vedderb/QuadcopterSystem/Documentation/Figures/HW_Diagram_Quadcopter.pdf

## Ranging Board

## Mainboard

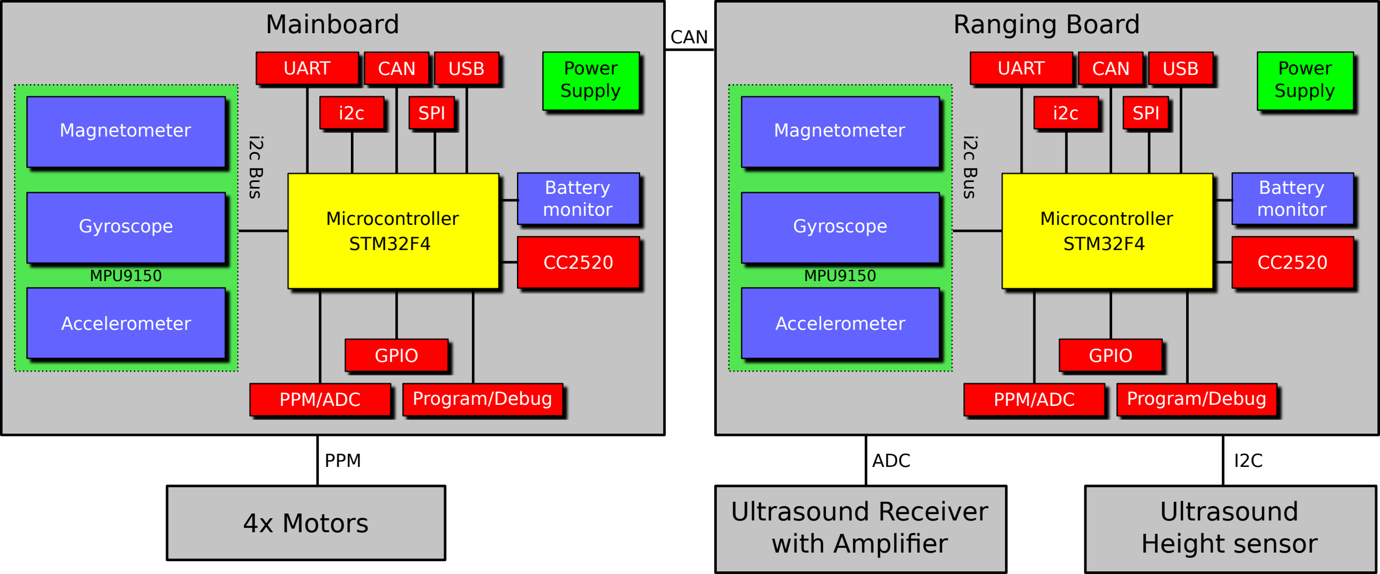
[picture p15: page 1]

Magnetometer

Gyroscope

Accelerometer

UART

i2c Bus

CAN | USB
PPM/ADC | Program/Debug

Power
Supply

CC2520

Microcontroller
STM32F4

i2c

GPIO

Battery
monitor

MPU9150

SPI

4x Motors | Ultrasound Height sensor

ADC

CAN

Magnetometer

Gyroscope

Accelerometer

UART

i2c Bus

CAN USB

Program/Debug PPM/ADC

Power
Supply

CC2520

Microcontroller
STM32F4

i2c

GPIO

Battery
monitor

MPU9150

SPI

## Ultrasound Receiver with Amplifier

PPM | I2C

PPM/ADC
