vedderb/QuadcopterSystem/Documentation/Figures/anchor.jpg

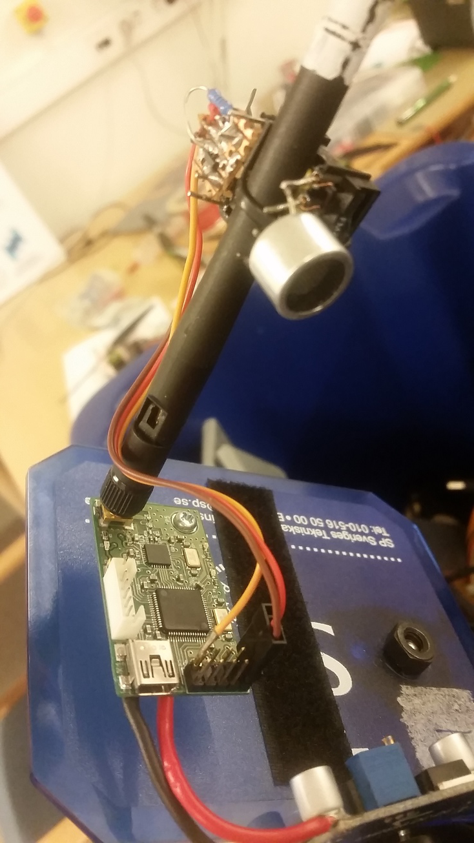
Documentation/Figures/anchor.jpg
