vedderb/QuadcopterSystem/Documentation/Figures/quad_pcb.jpg

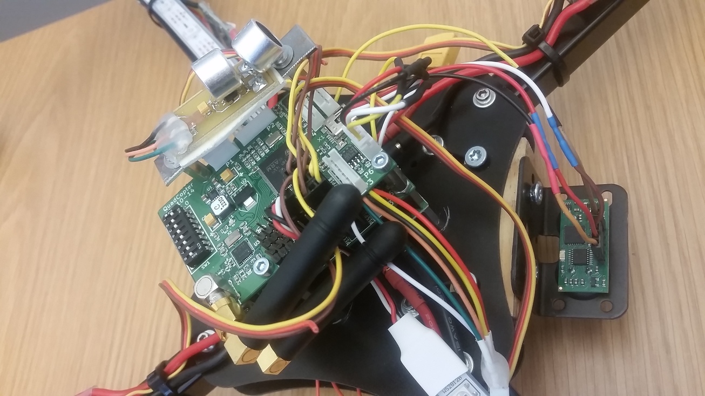
Documentation/Figures/quad_pcb.jpg
