vedderb/QuadcopterSystem/Documentation/Figures/quadcoptertool_3.png

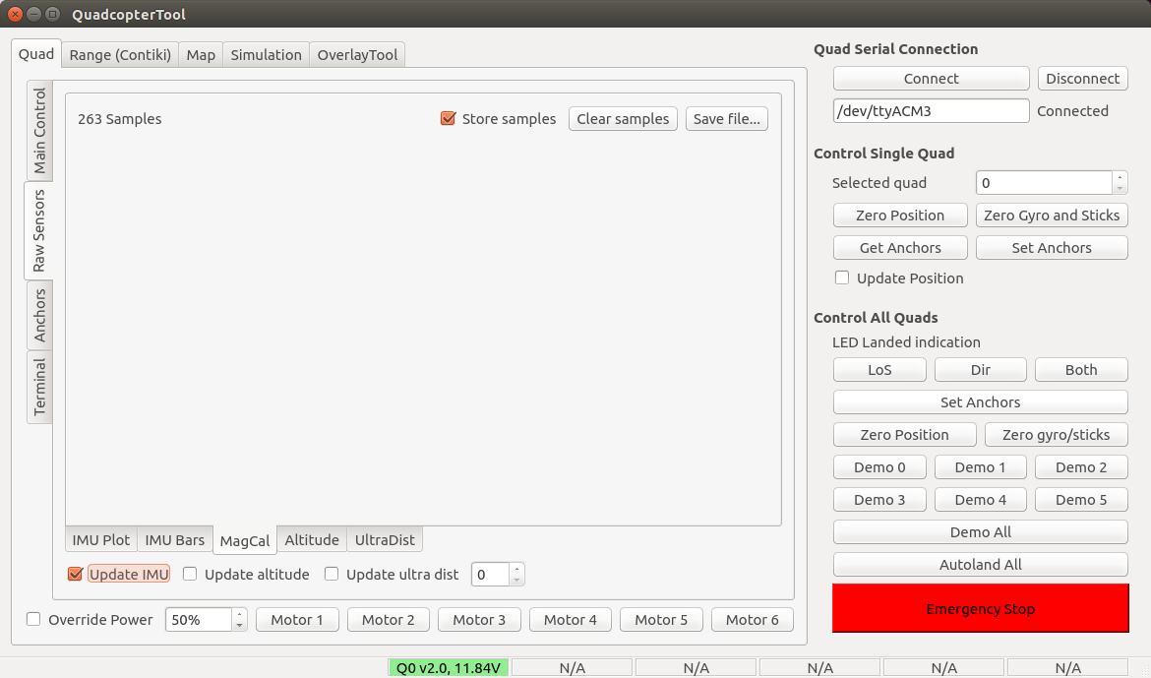
Documentation/Figures/quadcoptertool_3.png
