vedderb/QuadcopterSystem/Documentation/Figures/quadcoptertool_4.png

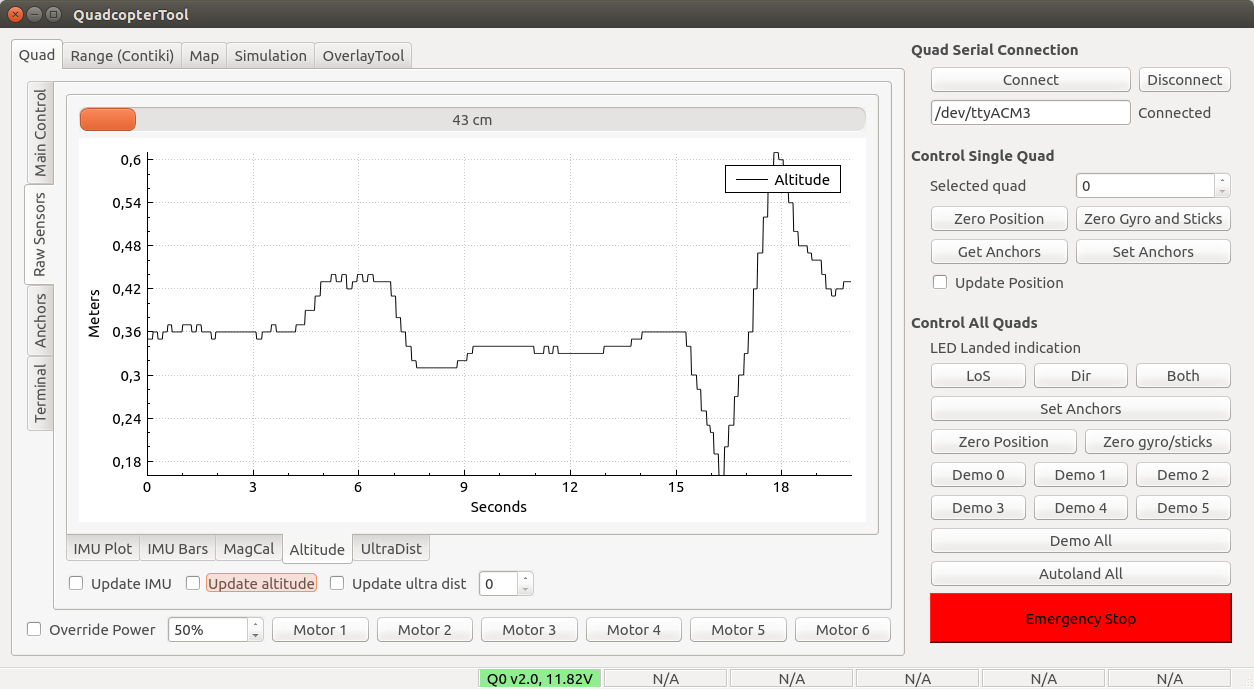
Documentation/Figures/quadcoptertool_4.png
