vedderb/QuadcopterSystem/Documentation/Figures_pdf_png/QuadcopterMain.png

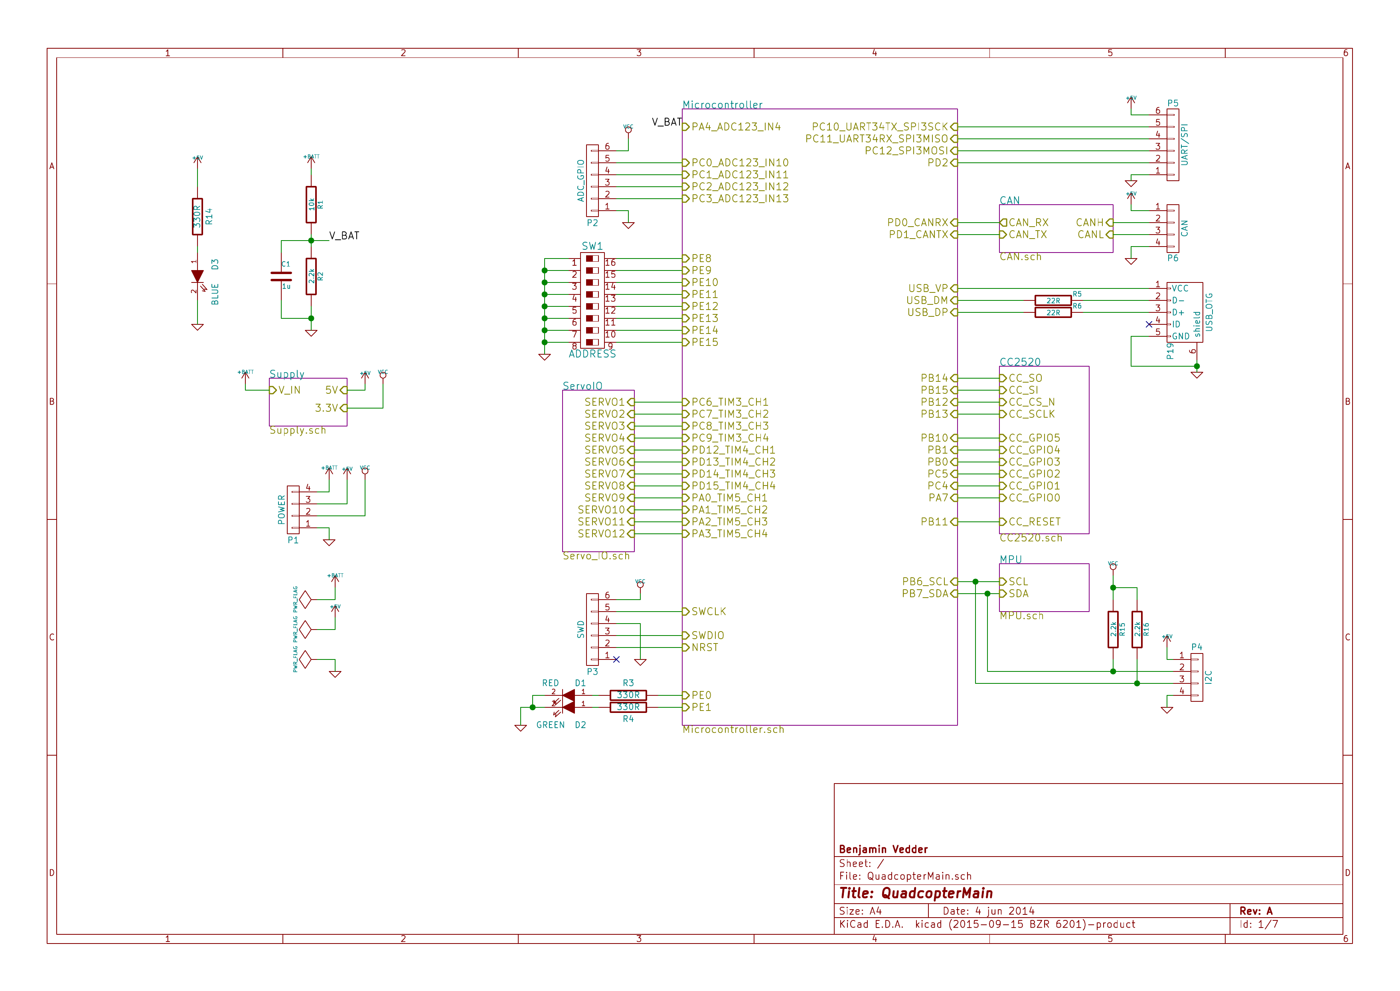
Documentation/Figures_pdf_png/QuadcopterMain.png
