vedderb/QuadcopterSystem/Hardware/MainBoard/Pictures/QuadcopterMain.png

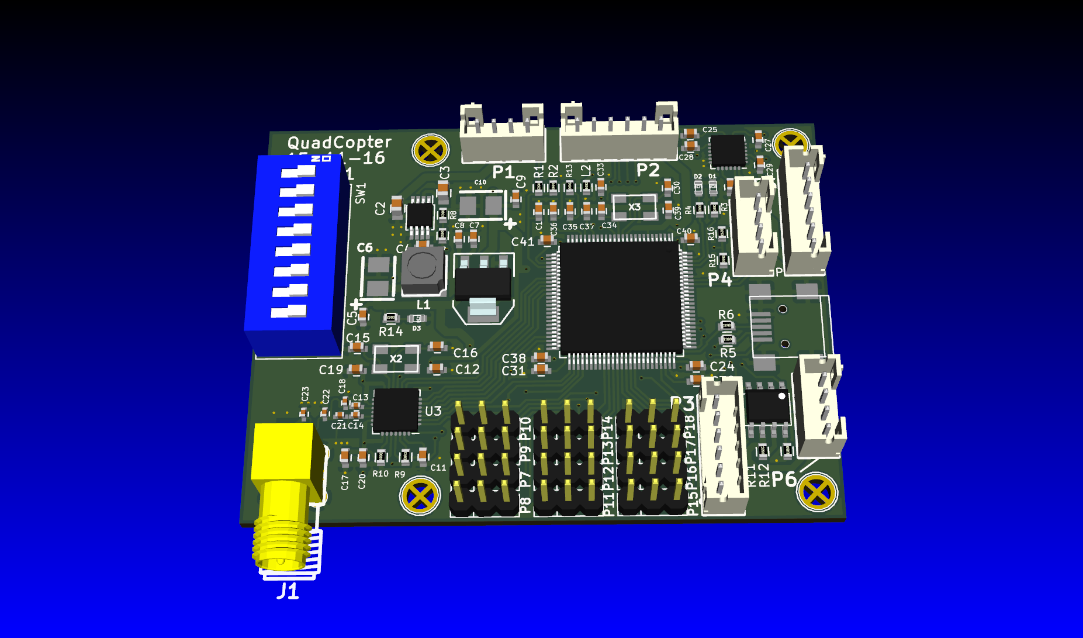
Hardware/MainBoard/Pictures/QuadcopterMain.png
