vedderb/QuadcopterSystem/(list of files, cad)

Other CAD files:
Linux/QuadcopterTool/Models/quadrotor_base.blend
