vedderb/QuadcopterSystem/Documentation/Figures/CopterSimSetupGUI.pdf

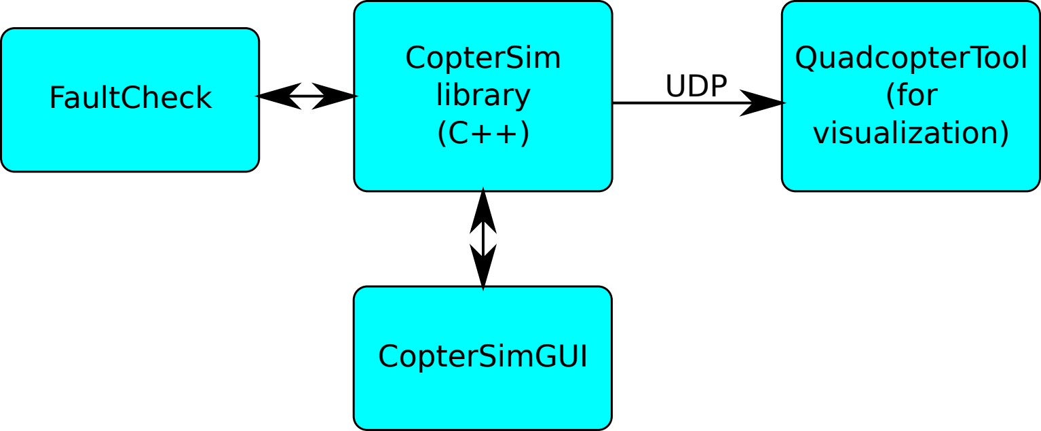
[picture p32: figure]
CopterSim library (C++); QuadcopterTool (for visualization); CopterSimGUI; UDP FaultCheck
