vedderb/QuadcopterSystem/Hardware/MainBoard/QuadcopterMain.pdf

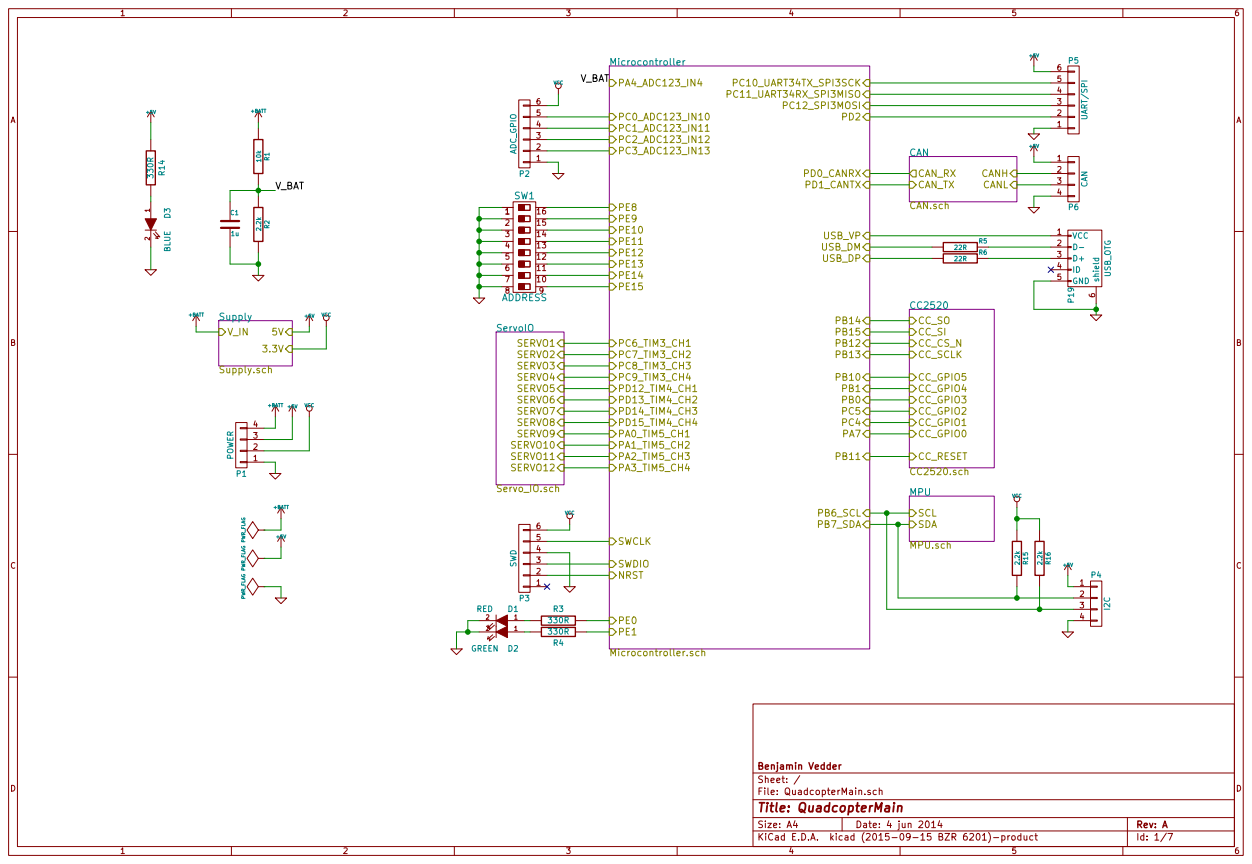
[picture p33: page 1]

File: QuadcopterMain.sch Sheet: / Benjamin Vedder

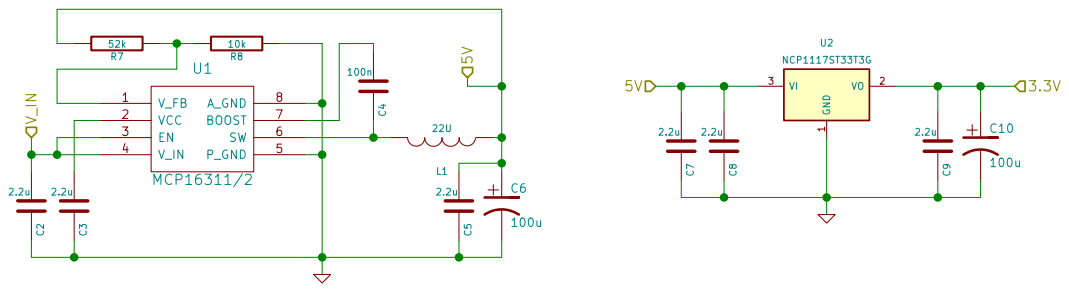
[picture p34: page 2]

Benjamin Vedder
Sheet: /Supply/
File: Supply.sch
Id: 2/7 Title: Voltage regulators

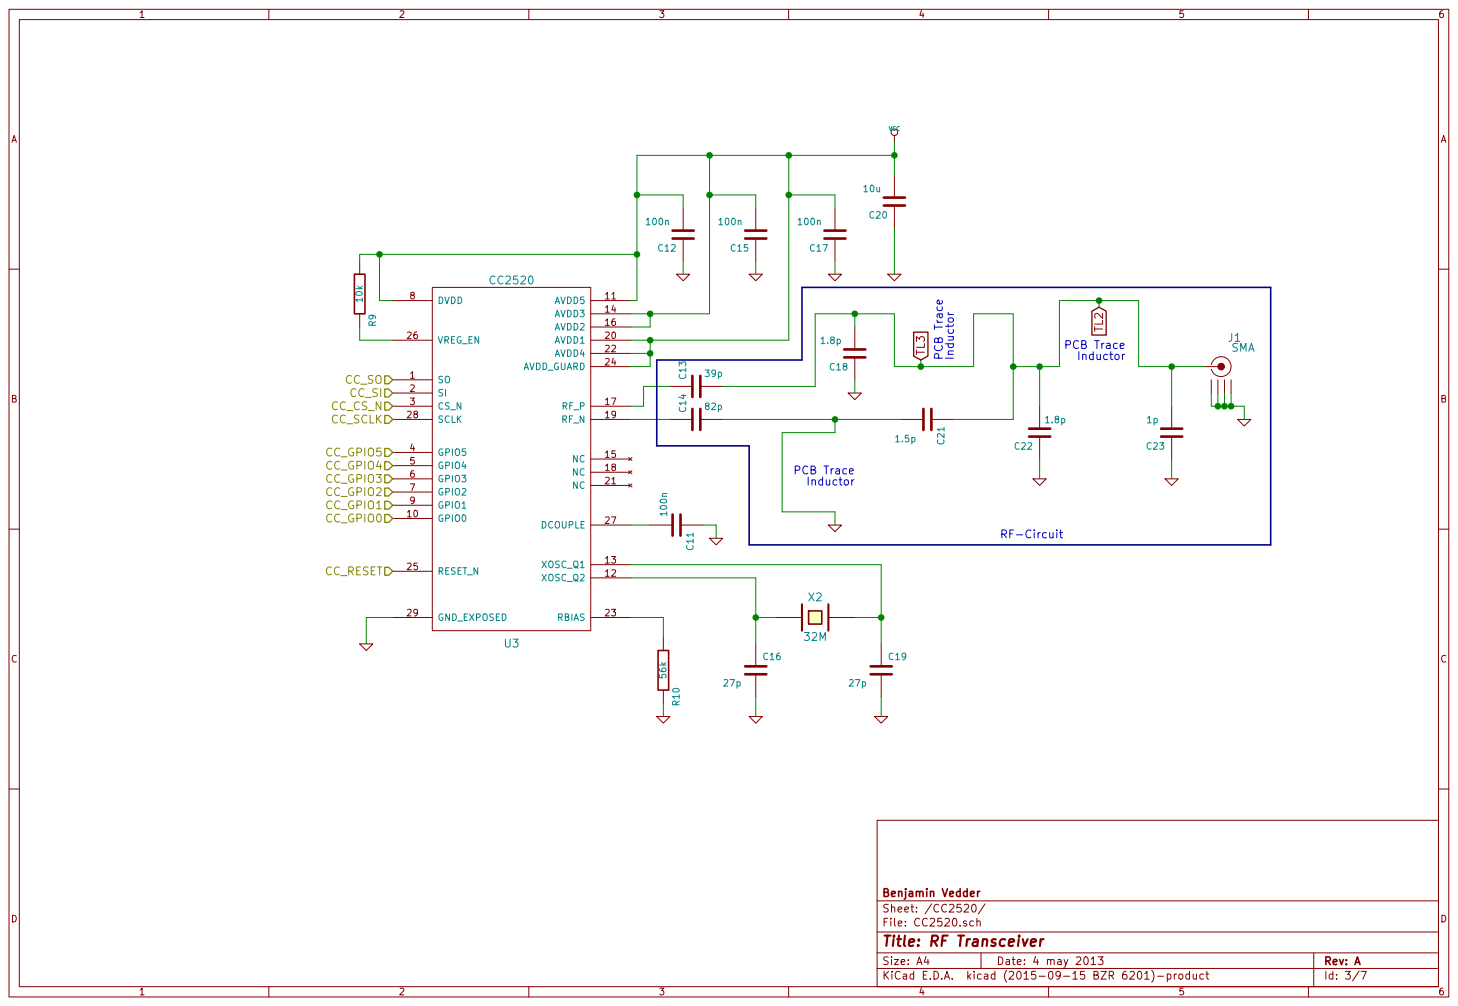
[picture p35: page 3]

Id: 3/7 Title: RF Transceiver File: CC2520.sch Sheet: /CC2520/ Benjamin Vedder

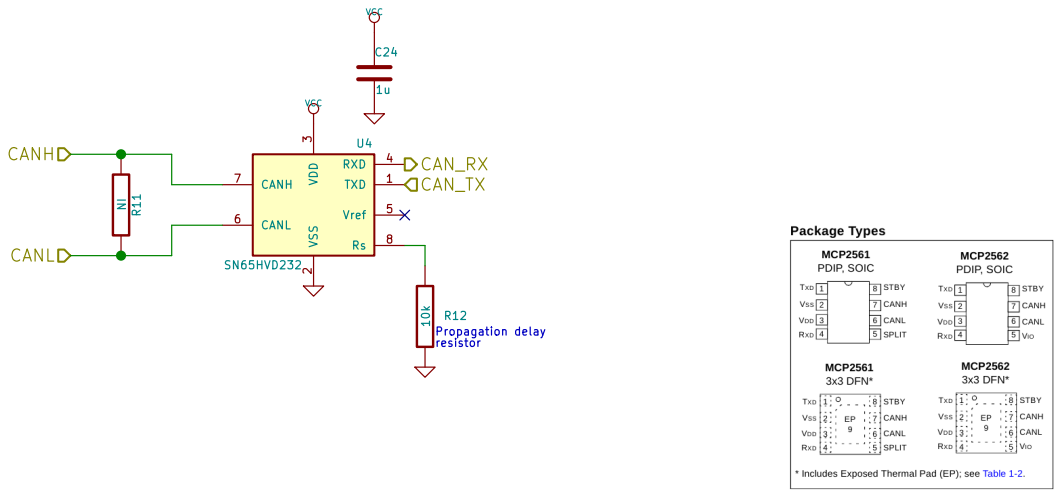
[picture p36: page 4]

3 RXD 4 Vref 5 CANL 6 CANH 7 Rs 8 U4 SN65HVD232

Id: 4/7 Title: CAN BUS transceiver File: CAN.sch Sheet: /CAN/ Benjamin Vedder

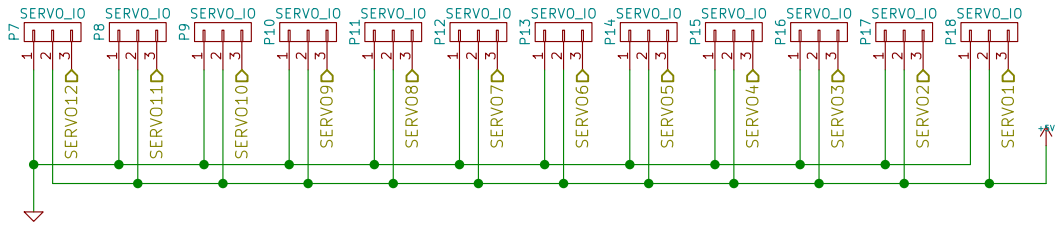
[picture p37: page 5]

File: Servo_IO.sch Sheet: /ServoIO/ Benjamin Vedder

Id: 5/7 Title: PPM IO

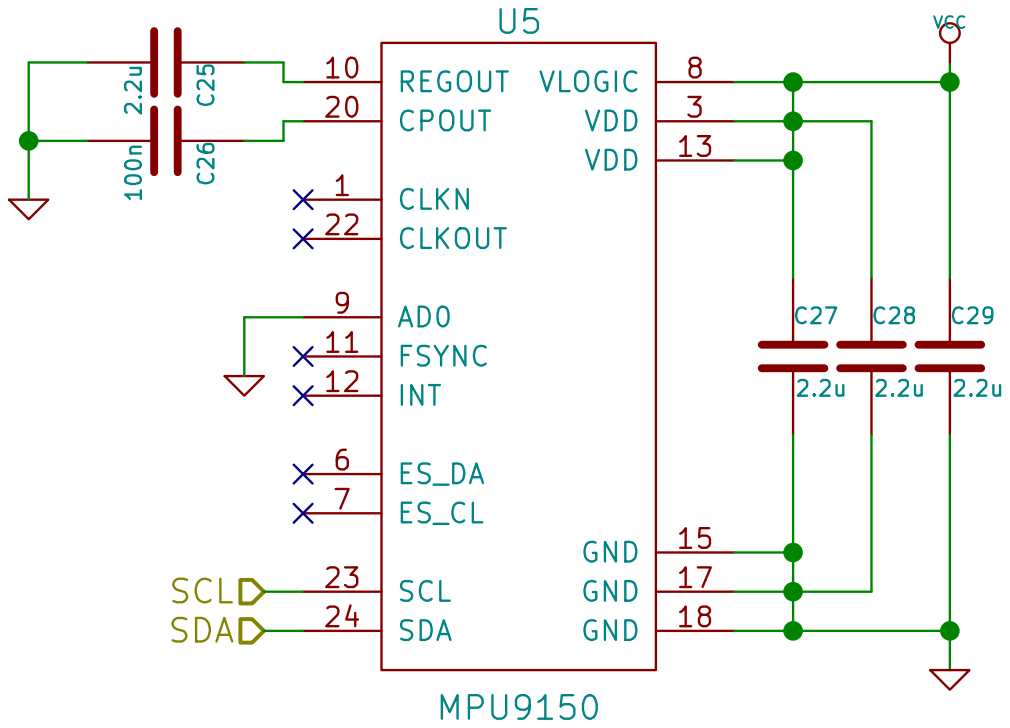
[picture p38: page 6]

File: MPU.sch Sheet: /MPU/ Benjamin Vedder

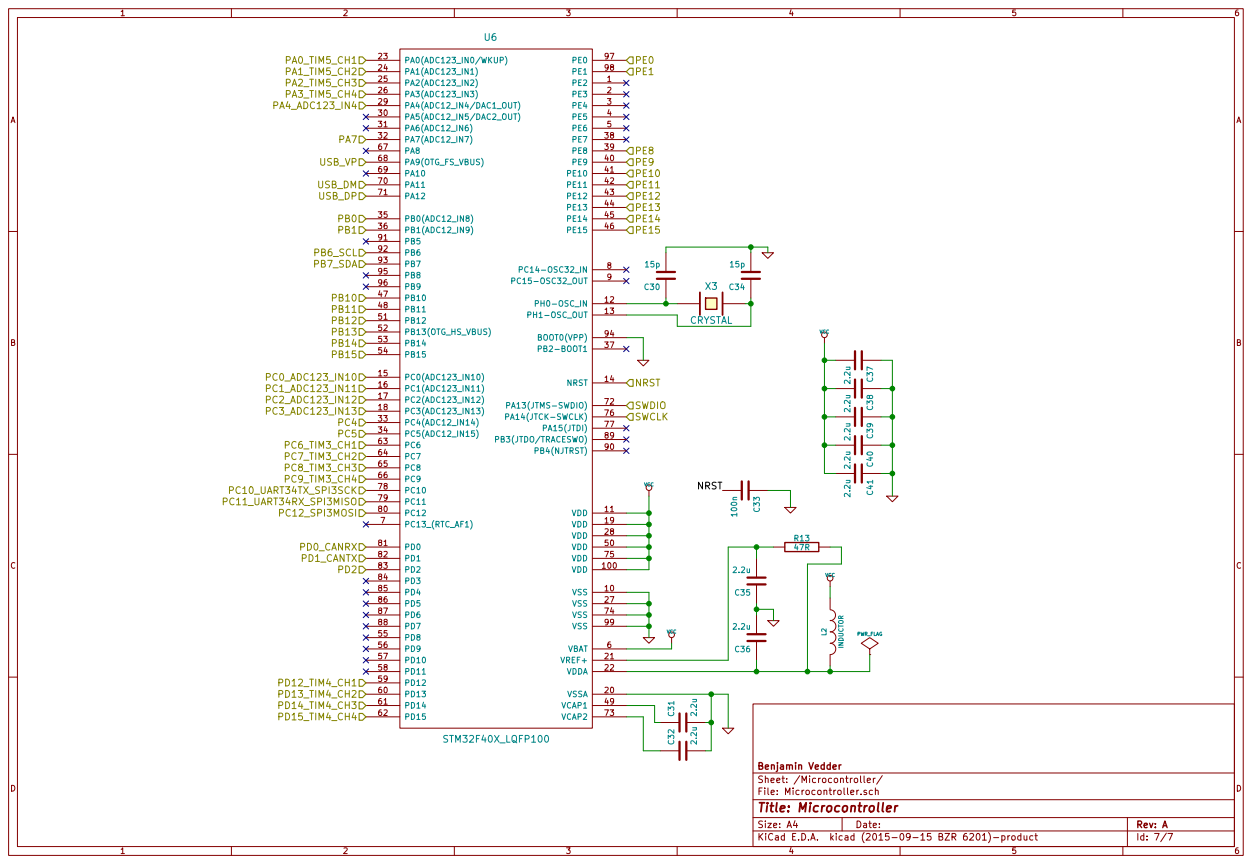
[picture p39: page 7]
