vedderb/QuadcopterSystem/Documentation/Figures/QuadHwSystem.pdf

# Linux Computer

# Clock Synchronization

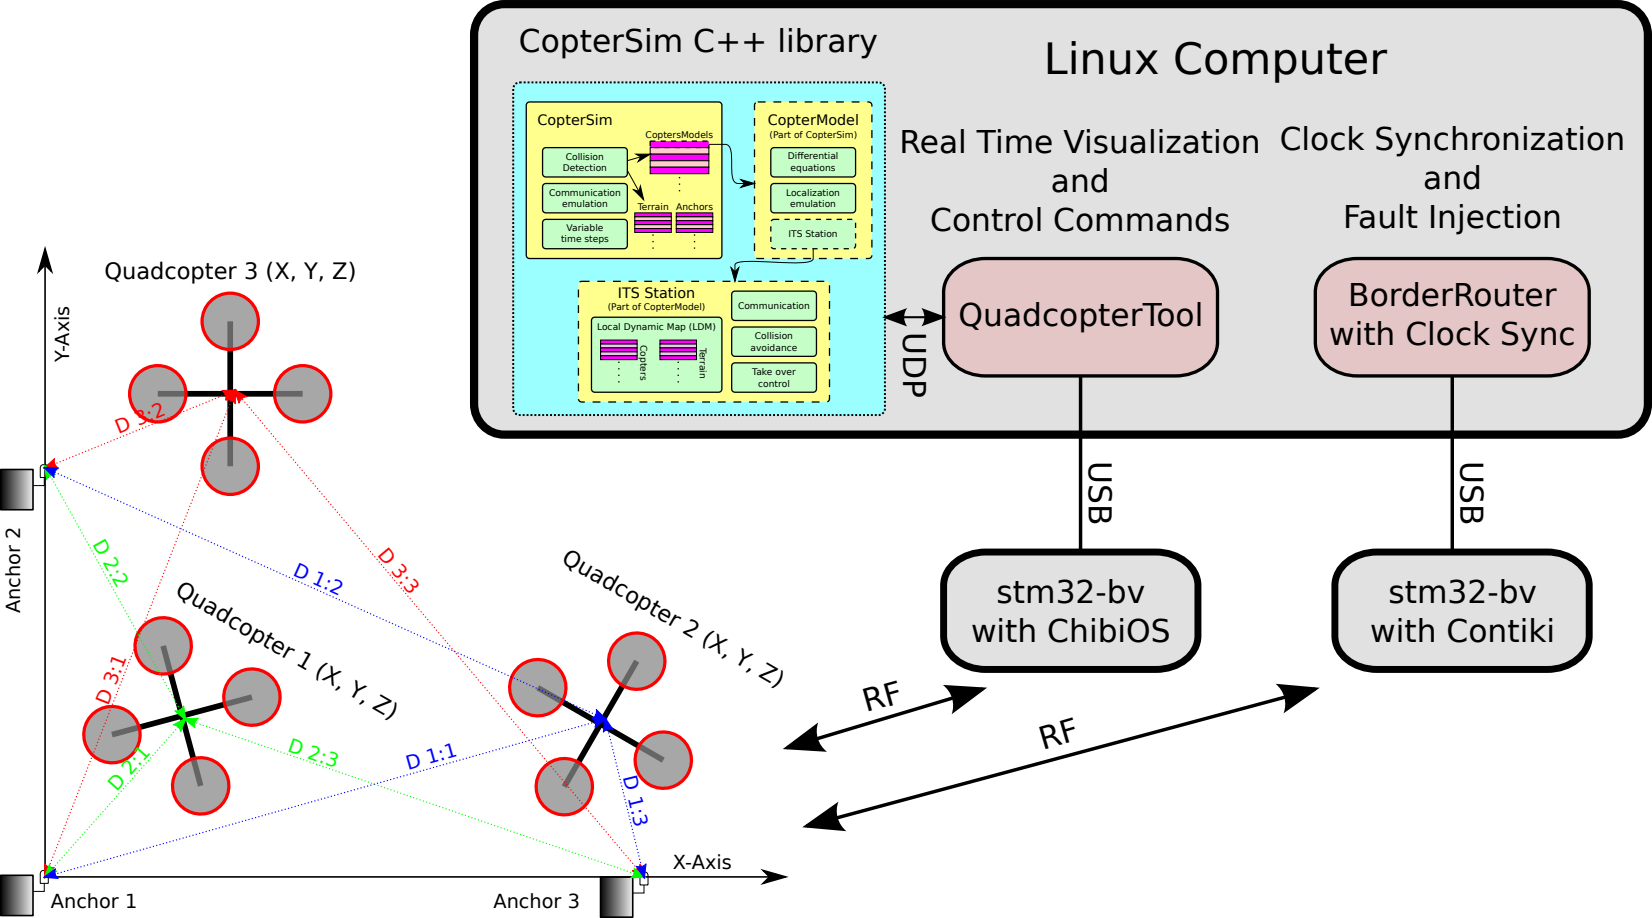
[picture p40: page 1]
X-Axis; Y-Axis; Anchor 1; Anchor 2; Anchor 3; Quadcopter 1 (X, Y, Z); Quadcopter 2 (X, Y, Z); Quadcopter 3 (X, Y, Z); QuadcopterTool; BorderRouter; stm32-bv with ChibiOS; stm32-bv with Contiki; USB; and Fault Injection; and Control Commands; CopterSim; Collision Detection; Communication emulation; Variable time steps; CoptersModels; Differential equations; ITS Station; CopterSim C++ library; Local Dynamic Map (LDM) Copters; Terrain; Communication; Collision avoidance; Take over control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

CopterModel
(Part of CopterSim)

Real Time Visualization

ITS Station
(Part of CopterModel)

with Clock Sync
