vedderb/QuadcopterSystem/Documentation/Figures/CopterSim.pdf

## CopterSim

## CopterModel

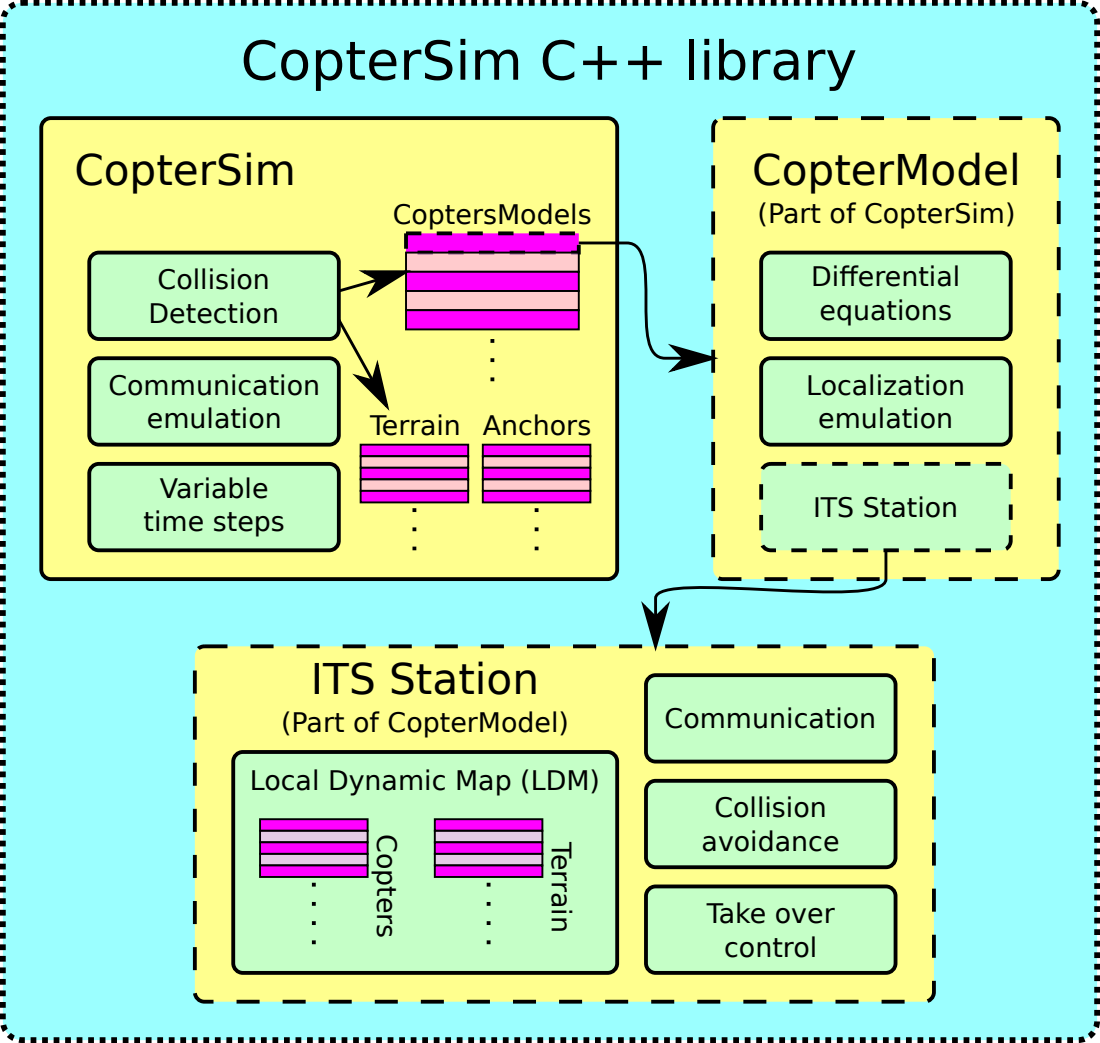
[picture p41: page 1]
Collision Detection; Communication emulation; Variable time steps; CoptersModels; Differential equations; ITS Station; CopterSim C++ library; Local Dynamic Map (LDM) Copters; Terrain; Communication; Collision avoidance; Take over control; Localization; Anchors; emulation

(Part of CopterSim)

ITS Station
(Part of CopterModel)
