vedderb/QuadcopterSystem/Hardware/MainBoard/QuadcopterMain.kicad_pcb

## KiCad design Hardware/MainBoard/QuadcopterMain.kicad_pcb (2015-12-16)

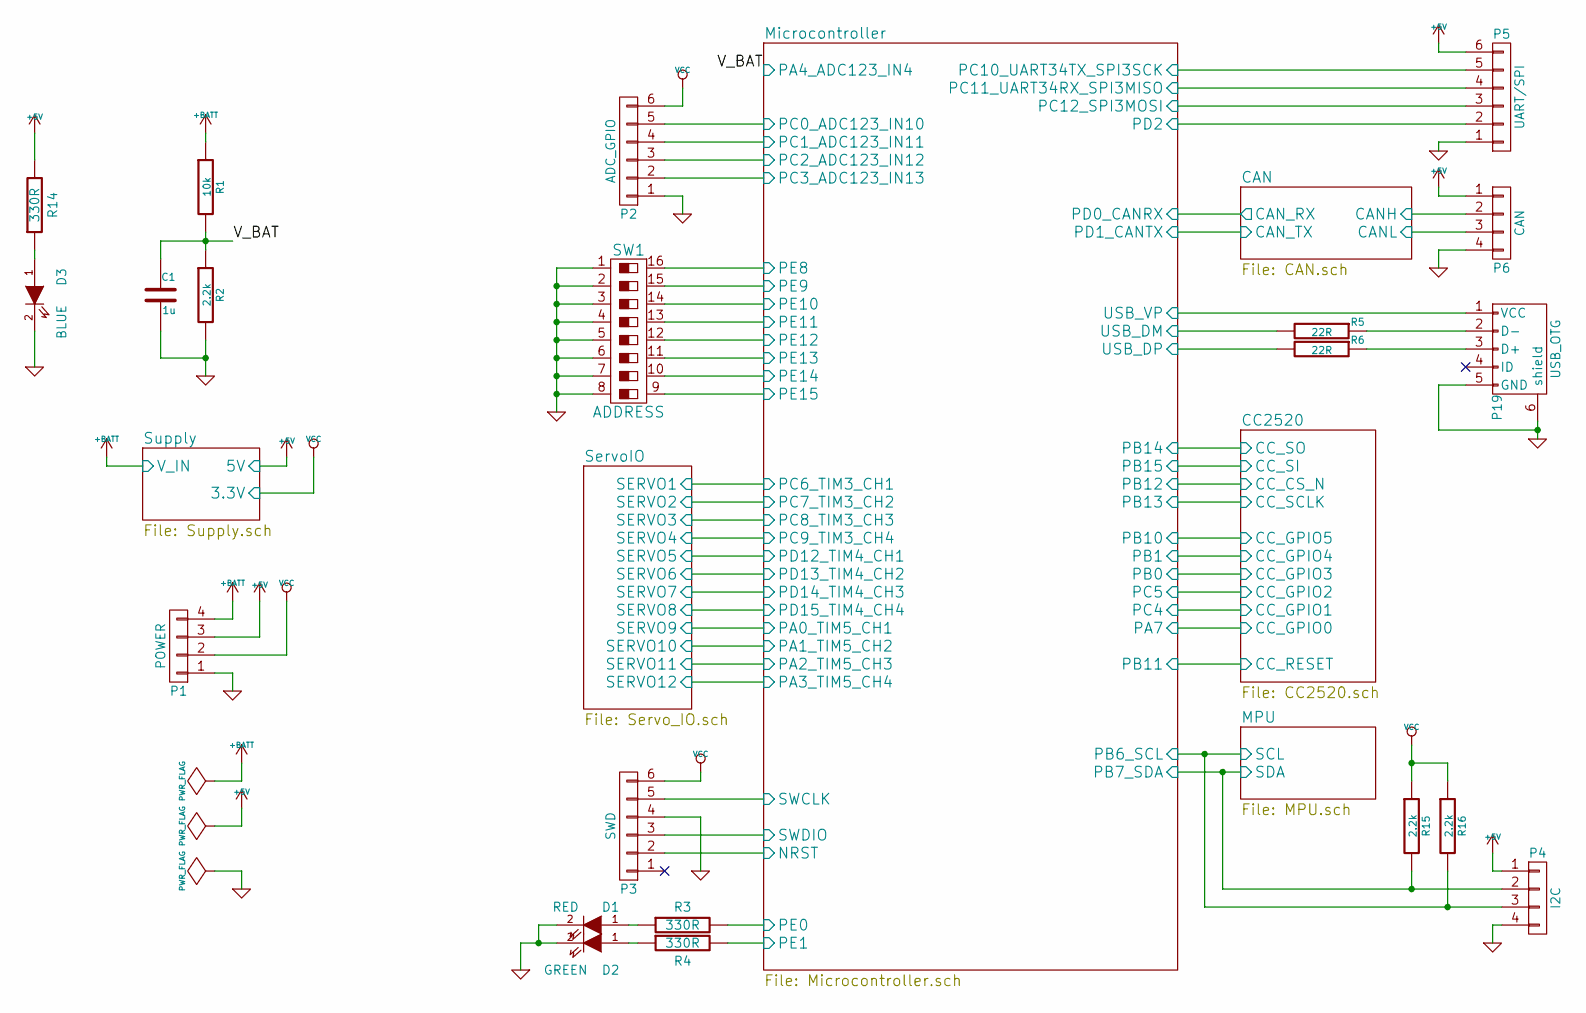
[picture p42: schematic QuadcopterMain.sch]

Parts:
C1: 1u; C_0603
D1: RED; LED-0603
D2: GREEN; LED-0603
D3: BLUE; LED-0603
P1: POWER; b4b-ph-kl
P2: ADC_GPIO; b6b-ph-kl
P3: SWD; b6b-ph-kl
P4: I2C; b4b-ph-kl
P5: UART/SPI; b6b-ph-kl
P6: CAN; b4b-ph-kl
P19: USB_OTG; USB_Mini-B
R1: 10k; R_0603
R2, R15, R16: 2.2k; R_0603
R3, R4, R14: 330R; R_0603
R5, R6: 22R; R_0603
SW1: ADDRESS; SW_DIP_x8_Slide

Connections:
+5V: P1.3, P4.1, P5.6, P6.1, R14.2; also elsewhere on the board
+BATT: P1.4, R1.1; also elsewhere on the board
/CAN/CANH: P6.2; also elsewhere on the board
/CAN/CANL: P6.3; also elsewhere on the board
/Microcontroller/NRST: P3.2; also elsewhere on the board
/Microcontroller/PA4_ADC123_IN4: C1.1, R1.2, R2.1; also elsewhere on the board
/Microcontroller/PB6_SCL: P4.3, R16.2; also elsewhere on the board
/Microcontroller/PB7_SDA: P4.2, R15.2; also elsewhere on the board
/Microcontroller/PC0_ADC123_IN10: P2.5; also elsewhere on the board
/Microcontroller/PC1_ADC123_IN11: P2.4; also elsewhere on the board
/Microcontroller/PC2_ADC123_IN12: P2.3; also elsewhere on the board
/Microcontroller/PC3_ADC123_IN13: P2.2; also elsewhere on the board
/Microcontroller/PC10_UART34TX_SPI3SCK: P5.5; also elsewhere on the board
/Microcontroller/PC11_UART34RX_SPI3MISO: P5.4; also elsewhere on the board
/Microcontroller/PC12_SPI3MOSI: P5.3; also elsewhere on the board
/Microcontroller/PD2: P5.2; also elsewhere on the board
/Microcontroller/PE0: R3.2; also elsewhere on the board
/Microcontroller/PE1: R4.2; also elsewhere on the board
/Microcontroller/PE8: SW1.16; also elsewhere on the board
/Microcontroller/PE9: SW1.15; also elsewhere on the board
/Microcontroller/PE10: SW1.14; also elsewhere on the board
/Microcontroller/PE11: SW1.13; also elsewhere on the board
/Microcontroller/PE12: SW1.12; also elsewhere on the board
/Microcontroller/PE13: SW1.11; also elsewhere on the board
/Microcontroller/PE14: SW1.10; also elsewhere on the board
/Microcontroller/PE15: SW1.9; also elsewhere on the board
/Microcontroller/SWCLK: P3.5; also elsewhere on the board
/Microcontroller/SWDIO: P3.3; also elsewhere on the board
/Microcontroller/USB_DM: R5.2; also elsewhere on the board
/Microcontroller/USB_DP: R6.2; also elsewhere on the board
/Microcontroller/USB_VP: P19.1 (VCC); also elsewhere on the board
GND: C1.2, D1.2 (K), D2.2 (K), D3.2 (K), P1.1, P2.1, P3.4, P4.4, P5.1, P6.4, P19.5 (GND), P19.6 (shield), R2.2, SW1.1, SW1.2, SW1.3, SW1.4, SW1.5, SW1.6, SW1.7, SW1.8; also elsewhere on the board
unnamed: D1.1 (A), R3.1
unnamed: D2.1 (A), R4.1
unnamed: D3.1 (A), R14.1
unnamed: P19.2 (D-), R5.1
unnamed: P19.3 (D+), R6.1
VCC: P1.2, P2.6, P3.6, R15.1, R16.1; also elsewhere on the board

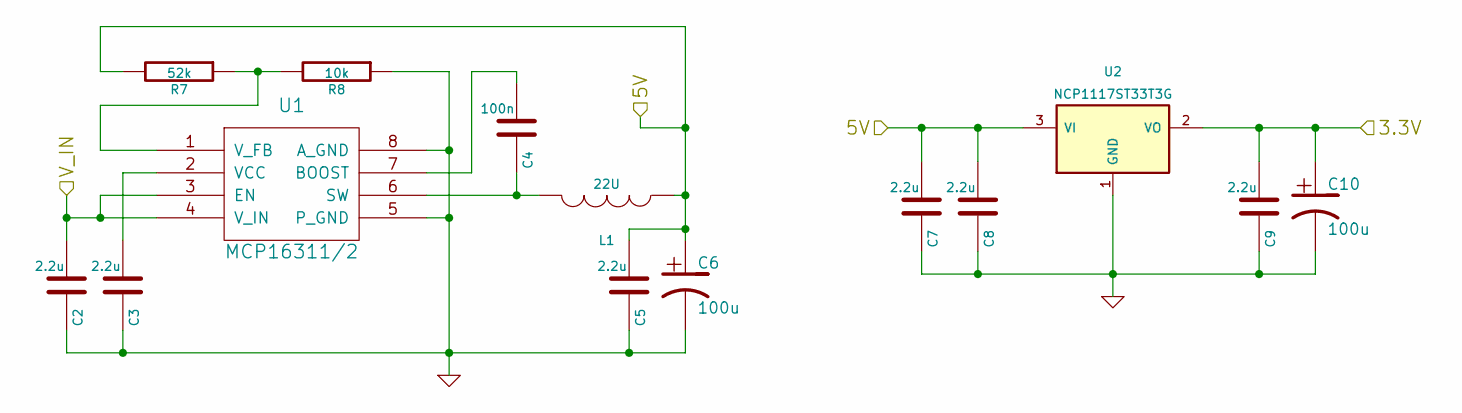
[picture p43: schematic Supply.sch, Voltage regulators]

Parts:
C2, C3: 2.2u; C_0805
C4: 100n; C_0603
C5, C7, C8, C9: 2.2u; C_0603
C6, C10: 100u; TantalC_SizeB_EIA-3528_Reflow
L1: 22U; inductor_smd_4.8x2.8mm
R7: 52k; R_0603
R8: 10k; R_0603
U1: MCP16311/2; MSOP-8_3x3mm_Pitch0.65mm
U2: NCP1117ST33T3G; SOT-223

Connections:
+5V: C5.2, C6.1, C7.2, C8.2, L1.1, R7.2, U2.3 (VI); also elsewhere on the board
+BATT: C2.2, U1.3 (EN), U1.4 (V_IN); also elsewhere on the board
GND: C2.1, C3.1, C5.1, C6.2, C7.1, C8.1, C9.1, C10.2, R8.1, U1.5 (P_GND), U1.8 (A_GND), U2.1 (GND); also elsewhere on the board
unnamed: C3.2, U1.2 (VCC)
unnamed: C4.1, L1.2, U1.6 (SW)
unnamed: C4.2, U1.7 (BOOST)
unnamed: R7.1, R8.2, U1.1 (V_FB)
VCC: C9.2, C10.1, U2.2 (VO); also elsewhere on the board

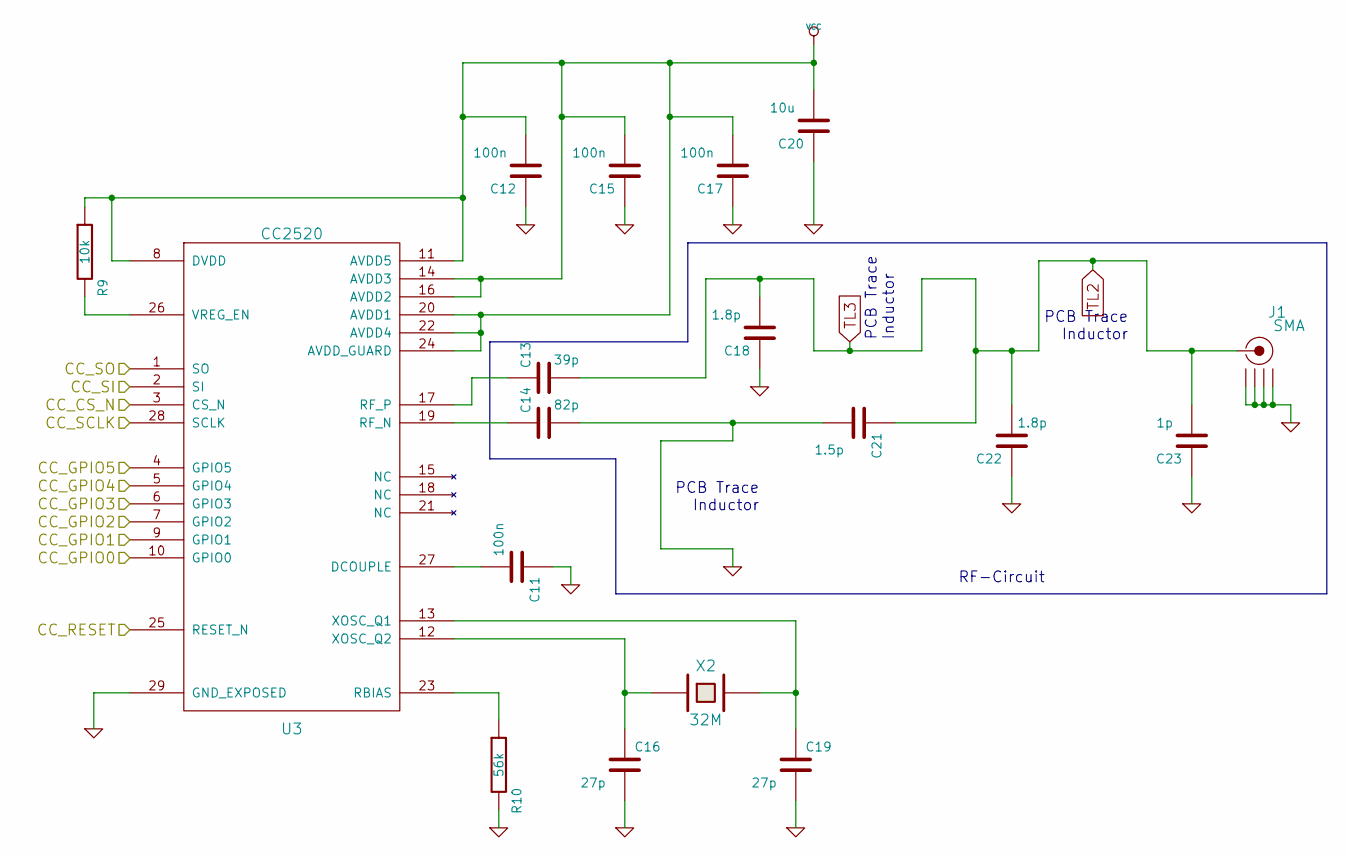
[picture p44: schematic CC2520.sch, RF Transceiver]

Parts:
C11, C12, C15, C17: 100n; C_0603
C13: 39p; C_0402
C14: 82p; C_0402
C16, C19: 27p; C_0603
C18, C22: 1.8p; C_0402
C20: 10u; C_0603
C21: 1.5p; C_0402
C23: 1p; C_0402
J1: SMA; sma_90_r300.124.403
R9: 10k; R_0603
R10: 56k; R_0603
U3: CC2520; QFN-28-1EP_5x5mm_Pitch0.5mm
X2: 32M; Crystal_5x3mm

Connections:
/CC2520/CC_CS_N: U3.3 (CS_N); also elsewhere on the board
/CC2520/CC_GPIO0: U3.10 (GPIO0); also elsewhere on the board
/CC2520/CC_GPIO1: U3.9 (GPIO1); also elsewhere on the board
/CC2520/CC_GPIO2: U3.7 (GPIO2); also elsewhere on the board
/CC2520/CC_GPIO3: U3.6 (GPIO3); also elsewhere on the board
/CC2520/CC_GPIO4: U3.5 (GPIO4); also elsewhere on the board
/CC2520/CC_GPIO5: U3.4 (GPIO5); also elsewhere on the board
/CC2520/CC_RESET: U3.25 (RESET_N); also elsewhere on the board
/CC2520/CC_SCLK: U3.28 (SCLK); also elsewhere on the board
/CC2520/CC_SI: U3.2 (SI); also elsewhere on the board
/CC2520/CC_SO: U3.1 (SO); also elsewhere on the board
GND: C11.1, C12.1, C14.2, C15.1, C16.2, C17.1, C18.1, C19.2, C20.1, C21.2, C22.1, C23.1, J1.2 (GND1), J1.3 (GND2), J1.4 (GND3), J1.5 (GND4), R10.2, U3.29 (GND_EXPOSED); also elsewhere on the board
unnamed: C11.2, U3.27 (DCOUPLE)
unnamed: C13.1, U3.17 (RF_P)
unnamed: C14.1, U3.19 (RF_N)
unnamed: C16.1, U3.12 (XOSC_Q2), X2.1
unnamed: C19.1, U3.13 (XOSC_Q1), X2.2
unnamed: R9.2, U3.26 (VREG_EN)
unnamed: R10.1, U3.23 (RBIAS)
TL2: C13.2, C18.2, C21.1, C22.2, C23.2, J1.1 (RF)
VCC: C12.2, C15.2, C17.2, C20.2, R9.1, U3.8 (DVDD), U3.11 (AVDD5), U3.14 (AVDD3), U3.16 (AVDD2), U3.20 (AVDD1), U3.22 (AVDD4), U3.24 (AVDD_GUARD); also elsewhere on the board

Notes on the sheet:
RF-Circuit
PCB Trace Inductor

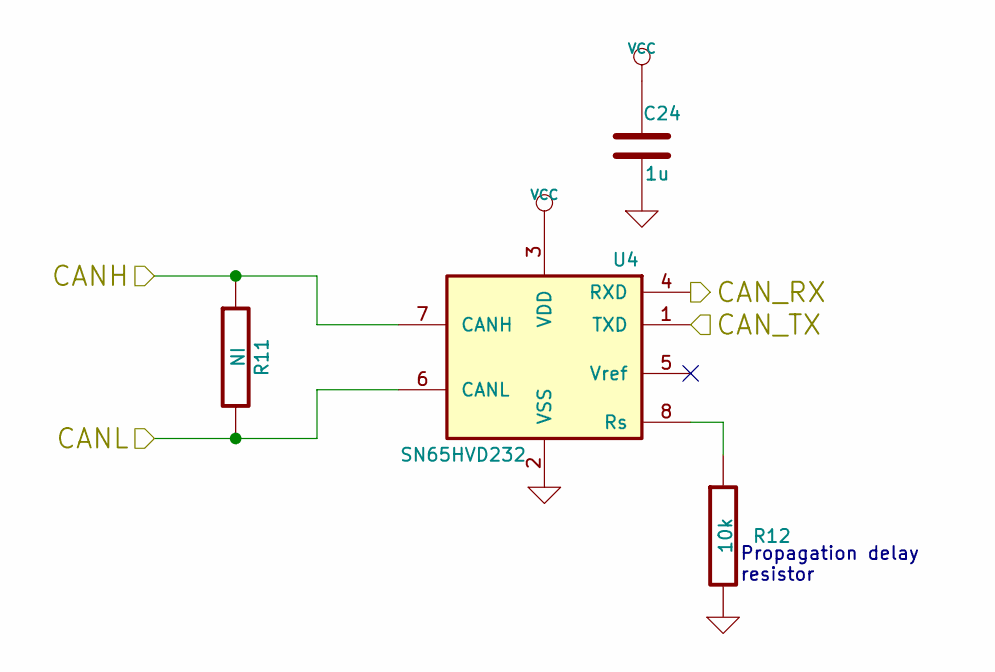
[picture p45: schematic CAN.sch, CAN BUS transceiver]

Parts:
C24: 1u; C_0603
R11: NI; R_0603
R12: 10k; R_0603
U4: SN65HVD232; SOIC-8-W

Connections:
/CAN/CANH: R11.1, U4.7 (CANH); also elsewhere on the board
/CAN/CANL: R11.2, U4.6 (CANL); also elsewhere on the board
/CAN/CAN_RX: U4.4 (RXD); also elsewhere on the board
/CAN/CAN_TX: U4.1 (TXD); also elsewhere on the board
GND: C24.2, R12.2, U4.2 (VSS); also elsewhere on the board
unnamed: R12.1, U4.8 (Rs)
VCC: C24.1, U4.3 (VDD); also elsewhere on the board

Notes on the sheet:
Propagation delay resistor

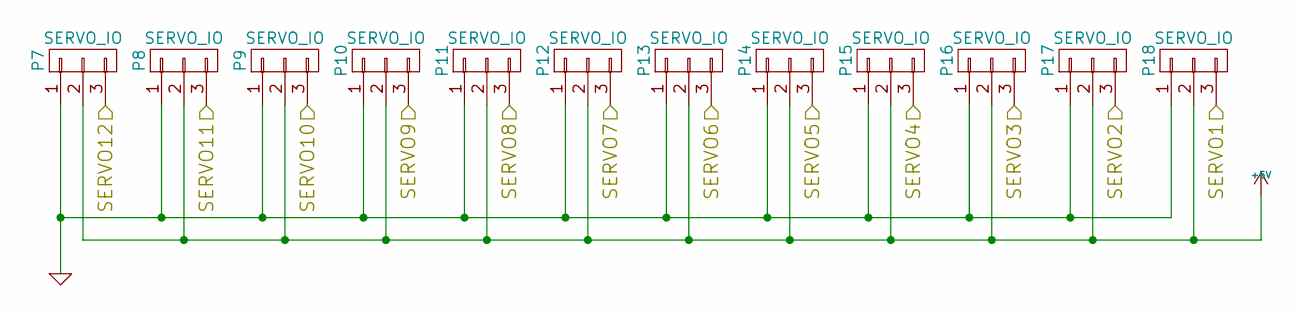
[picture p46: schematic Servo_IO.sch, PPM IO]

Parts:
P7, P8, P9, P10, P11, P12, P13, P14, P15, P16, P17, P18: SERVO_IO; Pin_Header_Straight_1x03

Connections:
+5V: P7.2, P8.2, P9.2, P10.2, P11.2, P12.2, P13.2, P14.2, P15.2, P16.2, P17.2, P18.2; also elsewhere on the board
/Microcontroller/PA0_TIM5_CH1: P10.3; also elsewhere on the board
/Microcontroller/PA1_TIM5_CH2: P9.3; also elsewhere on the board
/Microcontroller/PA2_TIM5_CH3: P8.3; also elsewhere on the board
/Microcontroller/PA3_TIM5_CH4: P7.3; also elsewhere on the board
/Microcontroller/PC6_TIM3_CH1: P18.3; also elsewhere on the board
/Microcontroller/PC7_TIM3_CH2: P17.3; also elsewhere on the board
/Microcontroller/PC8_TIM3_CH3: P16.3; also elsewhere on the board
/Microcontroller/PC9_TIM3_CH4: P15.3; also elsewhere on the board
/Microcontroller/PD12_TIM4_CH1: P14.3; also elsewhere on the board
/Microcontroller/PD13_TIM4_CH2: P13.3; also elsewhere on the board
/Microcontroller/PD14_TIM4_CH3: P12.3; also elsewhere on the board
/Microcontroller/PD15_TIM4_CH4: P11.3; also elsewhere on the board
GND: P7.1, P8.1, P9.1, P10.1, P11.1, P12.1, P13.1, P14.1, P15.1, P16.1, P17.1, P18.1; also elsewhere on the board

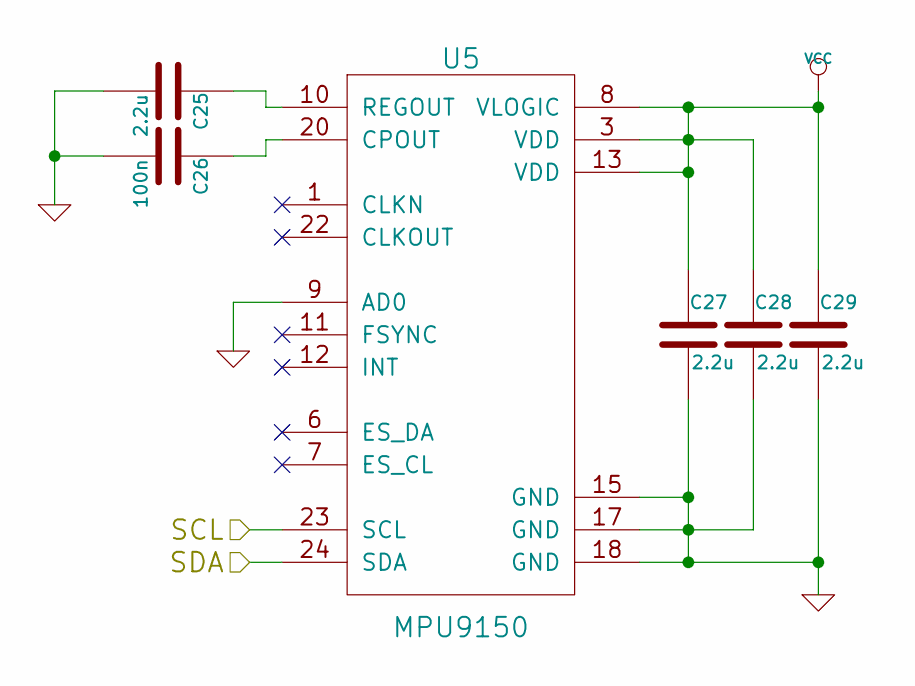
[picture p47: schematic MPU.sch, IMU]

Parts:
C25, C27, C28, C29: 2.2u; C_0603
C26: 100n; C_0603
U5: MPU9150; QFN-24-1EP_4x4mm_Pitch0.5mm

Connections:
/Microcontroller/PB6_SCL: U5.23 (SCL); also elsewhere on the board
/Microcontroller/PB7_SDA: U5.24 (SDA); also elsewhere on the board
GND: C25.2, C26.2, C27.2, C28.2, C29.2, U5.9 (AD0), U5.15 (GND), U5.17 (GND), U5.18 (GND); also elsewhere on the board
unnamed: C25.1, U5.10 (REGOUT)
unnamed: C26.1, U5.20 (CPOUT)
VCC: C27.1, C28.1, C29.1, U5.3 (VDD), U5.8 (VLOGIC), U5.13 (VDD); also elsewhere on the board

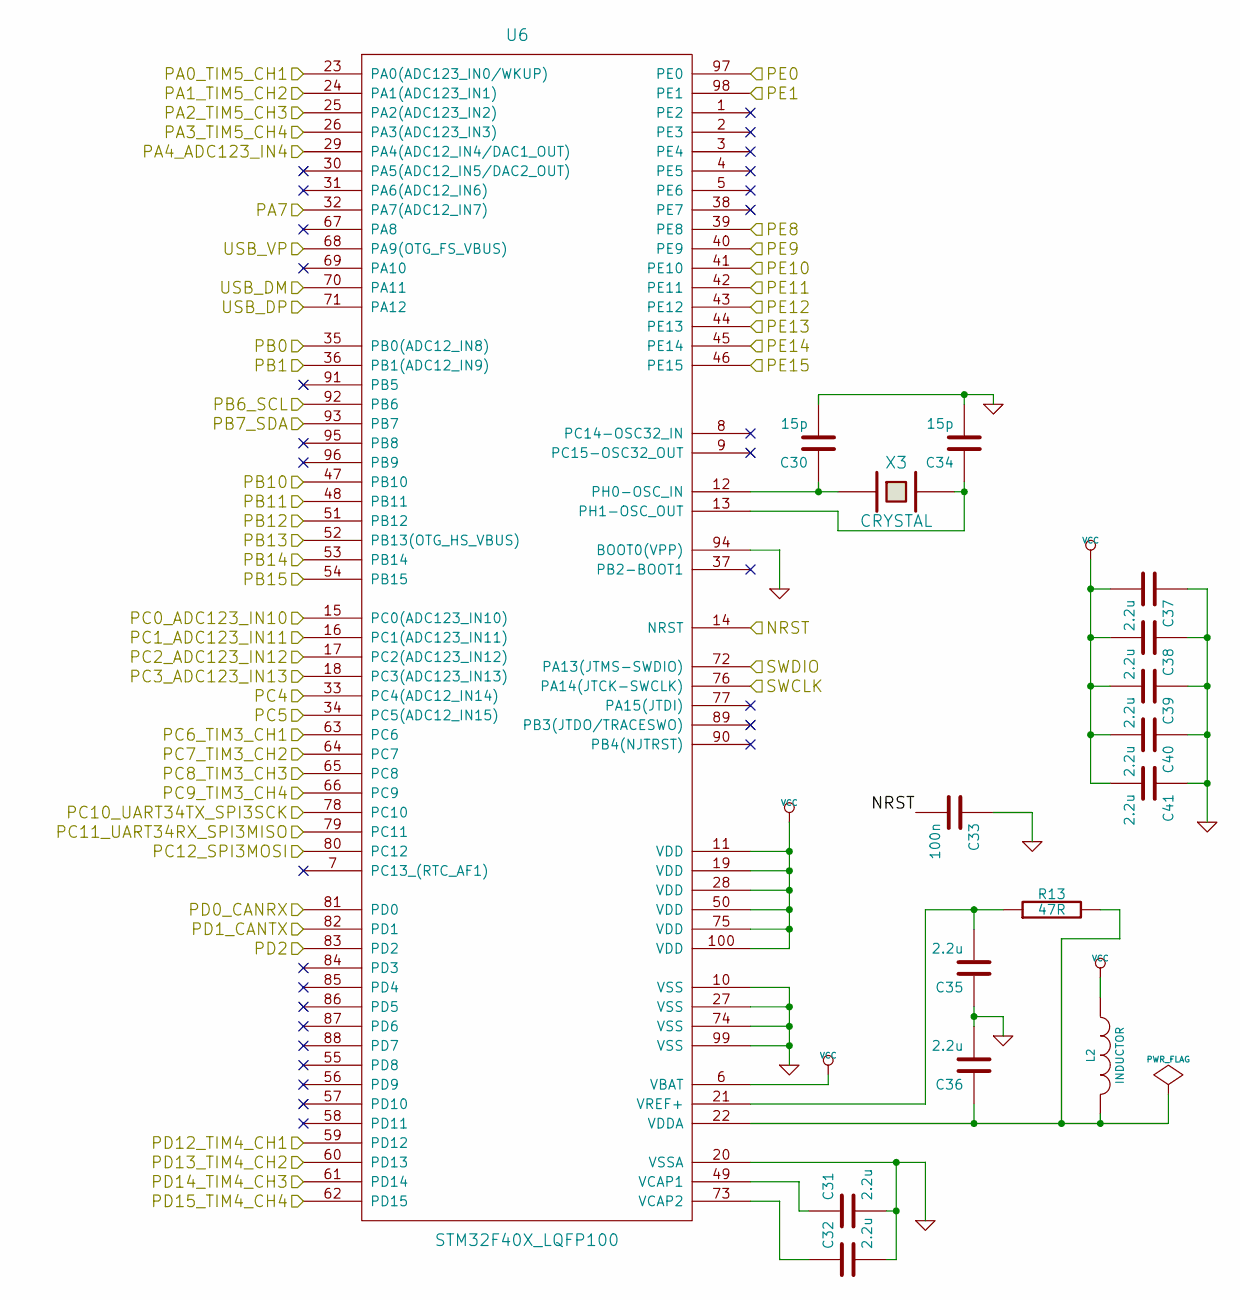
[picture p48: schematic Microcontroller.sch]

Parts:
C30, C34: 15p; C_0603
C31, C32, C35, C36, C37, C38, C39, C40, C41: 2.2u; C_0603
C33: 100n; C_0603
L2: INDUCTOR; R_0603
R13: 47R; R_0603
U6: STM32F40X_LQFP100; LQFP-100_14x14mm_Pitch0.5mm
X3: CRYSTAL; Crystal_5x3mm

Connections:
/CAN/CAN_RX: U6.81 (PD0); also elsewhere on the board
/CAN/CAN_TX: U6.82 (PD1); also elsewhere on the board
/CC2520/CC_CS_N: U6.51 (PB12); also elsewhere on the board
/CC2520/CC_GPIO0: U6.32 (PA7(ADC12_IN7)); also elsewhere on the board
/CC2520/CC_GPIO1: U6.33 (PC4(ADC12_IN14)); also elsewhere on the board
/CC2520/CC_GPIO2: U6.34 (PC5(ADC12_IN15)); also elsewhere on the board
/CC2520/CC_GPIO3: U6.35 (PB0(ADC12_IN8)); also elsewhere on the board
/CC2520/CC_GPIO4: U6.36 (PB1(ADC12_IN9)); also elsewhere on the board
/CC2520/CC_GPIO5: U6.47 (PB10); also elsewhere on the board
/CC2520/CC_RESET: U6.48 (PB11); also elsewhere on the board
/CC2520/CC_SCLK: U6.52 (PB13(OTG_HS_VBUS)); also elsewhere on the board
/CC2520/CC_SI: U6.54 (PB15); also elsewhere on the board
/CC2520/CC_SO: U6.53 (PB14); also elsewhere on the board
/Microcontroller/NRST: C33.2, U6.14 (NRST); also elsewhere on the board
/Microcontroller/PA0_TIM5_CH1: U6.23 (PA0(ADC123_IN0/WKUP)); also elsewhere on the board
/Microcontroller/PA1_TIM5_CH2: U6.24 (PA1(ADC123_IN1)); also elsewhere on the board
/Microcontroller/PA2_TIM5_CH3: U6.25 (PA2(ADC123_IN2)); also elsewhere on the board
/Microcontroller/PA3_TIM5_CH4: U6.26 (PA3(ADC123_IN3)); also elsewhere on the board
/Microcontroller/PA4_ADC123_IN4: U6.29 (PA4(ADC12_IN4/DAC1_OUT)); also elsewhere on the board
/Microcontroller/PB6_SCL: U6.92 (PB6); also elsewhere on the board
/Microcontroller/PB7_SDA: U6.93 (PB7); also elsewhere on the board
/Microcontroller/PC0_ADC123_IN10: U6.15 (PC0(ADC123_IN10)); also elsewhere on the board
/Microcontroller/PC1_ADC123_IN11: U6.16 (PC1(ADC123_IN11)); also elsewhere on the board
/Microcontroller/PC2_ADC123_IN12: U6.17 (PC2(ADC123_IN12)); also elsewhere on the board
/Microcontroller/PC3_ADC123_IN13: U6.18 (PC3(ADC123_IN13)); also elsewhere on the board
/Microcontroller/PC6_TIM3_CH1: U6.63 (PC6); also elsewhere on the board
/Microcontroller/PC7_TIM3_CH2: U6.64 (PC7); also elsewhere on the board
/Microcontroller/PC8_TIM3_CH3: U6.65 (PC8); also elsewhere on the board
/Microcontroller/PC9_TIM3_CH4: U6.66 (PC9); also elsewhere on the board
/Microcontroller/PC10_UART34TX_SPI3SCK: U6.78 (PC10); also elsewhere on the board
/Microcontroller/PC11_UART34RX_SPI3MISO: U6.79 (PC11); also elsewhere on the board
/Microcontroller/PC12_SPI3MOSI: U6.80 (PC12); also elsewhere on the board
/Microcontroller/PD2: U6.83 (PD2); also elsewhere on the board
/Microcontroller/PD12_TIM4_CH1: U6.59 (PD12); also elsewhere on the board
/Microcontroller/PD13_TIM4_CH2: U6.60 (PD13); also elsewhere on the board
/Microcontroller/PD14_TIM4_CH3: U6.61 (PD14); also elsewhere on the board
/Microcontroller/PD15_TIM4_CH4: U6.62 (PD15); also elsewhere on the board
/Microcontroller/PE0: U6.97 (PE0); also elsewhere on the board
/Microcontroller/PE1: U6.98 (PE1); also elsewhere on the board
/Microcontroller/PE8: U6.39 (PE8); also elsewhere on the board
/Microcontroller/PE9: U6.40 (PE9); also elsewhere on the board
/Microcontroller/PE10: U6.41 (PE10); also elsewhere on the board
/Microcontroller/PE11: U6.42 (PE11); also elsewhere on the board
/Microcontroller/PE12: U6.43 (PE12); also elsewhere on the board
/Microcontroller/PE13: U6.44 (PE13); also elsewhere on the board
/Microcontroller/PE14: U6.45 (PE14); also elsewhere on the board
/Microcontroller/PE15: U6.46 (PE15); also elsewhere on the board
/Microcontroller/SWCLK: U6.76 (PA14(JTCK-SWCLK)); also elsewhere on the board
/Microcontroller/SWDIO: U6.72 (PA13(JTMS-SWDIO)); also elsewhere on the board
/Microcontroller/USB_DM: U6.70 (PA11); also elsewhere on the board
/Microcontroller/USB_DP: U6.71 (PA12); also elsewhere on the board
/Microcontroller/USB_VP: U6.68 (PA9(OTG_FS_VBUS)); also elsewhere on the board
GND: C30.2, C31.2, C32.2, C33.1, C34.2, C35.1, C36.2, C37.1, C38.1, C39.1, C40.1, C41.1, U6.10 (VSS), U6.20 (VSSA), U6.27 (VSS), U6.74 (VSS), U6.94 (BOOT0(VPP)), U6.99 (VSS); also elsewhere on the board
unnamed: C30.1, U6.12 (PH0-OSC_IN), X3.1
unnamed: C31.1, U6.49 (VCAP1)
unnamed: C32.1, U6.73 (VCAP2)
unnamed: C34.1, U6.13 (PH1-OSC_OUT), X3.2
unnamed: C35.2, R13.1, U6.21 (VREF+)
unnamed: C36.1, L2.2, R13.2, U6.22 (VDDA)
VCC: C37.2, C38.2, C39.2, C40.2, C41.2, L2.1, U6.6 (VBAT), U6.11 (VDD), U6.19 (VDD), U6.28 (VDD), U6.50 (VDD), U6.75 (VDD), U6.100 (VDD); also elsewhere on the board

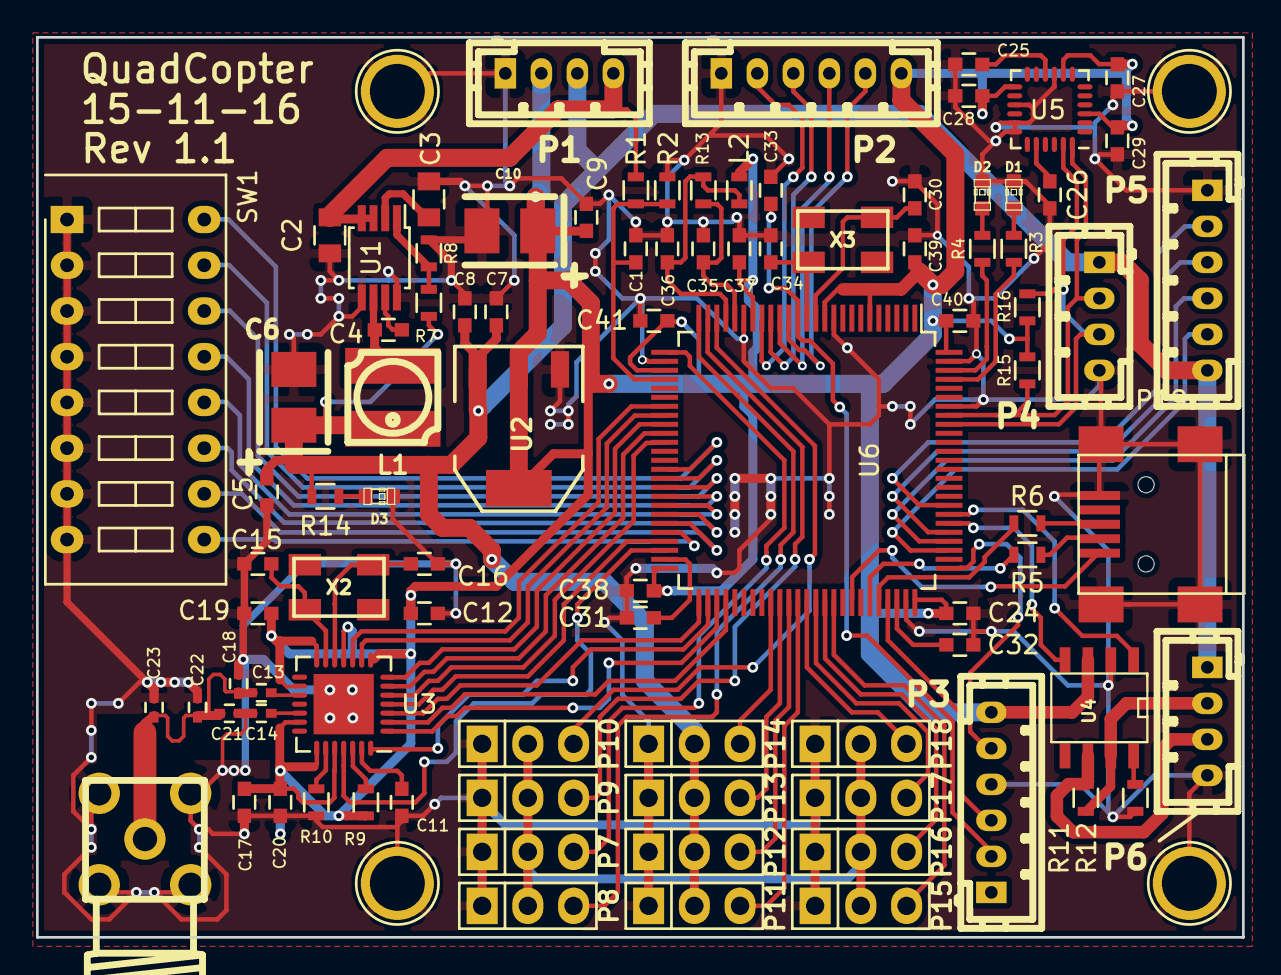
[picture p49: board QuadcopterMain.kicad_pcb from above]

Board: 2 copper layers, 67.0 x 50.0 mm, 91 parts (0 on the bottom side), 84 nets.
