vedderb/QuadcopterSystem/Embedded/border_router_clock_sync/border-router.c

/*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
 * This file is part of the Contiki operating system.
 *
 */
/**
 * \file
 *         border-router
 * \author
 *         Niclas Finne <nfi@sics.se>
 *         Joakim Eriksson <joakime@sics.se>
 *         Nicolas Tsiftes <nvt@sics.se>
 */

#include "contiki.h"
#include "contiki-lib.h"
#include "contiki-net.h"
#include "net/ip/uip.h"
#include "net/ipv6/uip-ds6.h"
#include "net/rpl/rpl.h"

#include "net/netstack.h"
#include "dev/slip.h"

#include <stdio.h>
#include <stdlib.h>
#include <string.h>
#include <ctype.h>

#define DEBUG DEBUG_NONE
#include "net/ip/uip-debug.h"
#include "debug-buffer.h"

#include "stm32f4xx_conf.h"
#include "dev/leds.h"

uint16_t dag_id[] = {0x1111, 0x1100, 0, 0, 0, 0, 0, 0x0011};

static uip_ipaddr_t prefix;
static uint8_t prefix_set;
static struct uip_udp_conn *client_conn;

PROCESS(border_router_process, "Border router process");

#if WEBSERVER==0
/* No webserver */
AUTOSTART_PROCESSES(&border_router_process);
#elif WEBSERVER>1
/* Use an external webserver application */
#include "webserver-nogui.h"
AUTOSTART_PROCESSES(&border_router_process,&webserver_nogui_process);
#else
/* Use simple webserver with only one page for minimum footprint.
 * Multiple conney
ctions can result in interleaved tcp segments since
 * a single static buffer is used for all segments.
 */
#include "httpd-simple.h"
/* The internal webserver can provide additional information if
 * enough program flash is available.
 */
#define WEBSERVER_CONF_LOADTIME 1
#define WEBSERVER_CONF_FILESTATS 1
#define WEBSERVER_CONF_NEIGHBOR_STATUS 1
/* Adding links requires a larger RAM buffer. To avoid static allocation
 * the stack can be used for formatting; however tcp retransmissions
 * and multiple connections can result in garbled segments.
 * TODO:use PSOCk_GENERATOR_SEND and tcp state storage to fix this.
 */
#define WEBSERVER_CONF_ROUTE_LINKS 1
#if WEBSERVER_CONF_ROUTE_LINKS
#define BUF_USES_STACK 0
#endif

PROCESS(webserver_nogui_process, "Web server");
PROCESS_THREAD(webserver_nogui_process, ev, data)
{
  PROCESS_BEGIN();

  httpd_init();

  while(1) {
    PROCESS_WAIT_EVENT_UNTIL(ev == tcpip_event);
    httpd_appcall(data);
  }
  
  PROCESS_END();
}
AUTOSTART_PROCESSES(&border_router_process,&webserver_nogui_process);

static const char *TOP = "<html><head><title>ContikiRPL</title></head><body>\n";
static const char *BOTTOM = "</body></html>\n";
#if BUF_USES_STACK
static char *bufptr, *bufend;
#define ADD(...) do {                                                   \
    bufptr += snprintf(bufptr, bufend - bufptr, __VA_ARGS__);      \
  } while(0)
#else
static char buf[2560];
static int blen;
#define ADD(...) do {                                                   \
    blen += snprintf(&buf[blen], sizeof(buf) - blen, __VA_ARGS__);      \
  } while(0)
#endif

/*---------------------------------------------------------------------------*/
static void
ipaddr_add(const uip_ipaddr_t *addr)
{
  uint16_t a;
  int i, f;
  for(i = 0, f = 0; i < sizeof(uip_ipaddr_t); i += 2) {
    a = (addr->u8[i] << 8) + addr->u8[i + 1];
    if(a == 0 && f >= 0) {
      if(f++ == 0) ADD("::");
    } else {
      if(f > 0) {
        f = -1;
      } else if(i > 0) {
        ADD(":");
      }
      ADD("%x", a);
    }
  }
}
/*---------------------------------------------------------------------------*/
static
PT_THREAD(generate_routes(struct httpd_state *s))
{
  static int i;
  static uip_ds6_route_t *r;
  static uip_ds6_nbr_t *nbr;
#if BUF_USES_STACK
  char buf[256];
#endif
#if WEBSERVER_CONF_LOADTIME
  static clock_time_t numticks;
  numticks = clock_time();
#endif

  PSOCK_BEGIN(&s->sout);

  SEND_STRING(&s->sout, TOP);
#if BUF_USES_STACK
  bufptr = buf;bufend=bufptr+sizeof(buf);
#else
  blen = 0;
#endif
  ADD("Neighbors<pre>");

  for(nbr = nbr_table_head(ds6_neighbors);
      nbr != NULL;
      nbr = nbr_table_next(ds6_neighbors, nbr)) {

#if WEBSERVER_CONF_NEIGHBOR_STATUS
#if BUF_USES_STACK
{char* j=bufptr+25;
      ipaddr_add(&nbr->ipaddr);
      while (bufptr < j) ADD(" ");
      switch (nbr->state) {
      case NBR_INCOMPLETE: ADD(" INCOMPLETE");break;
      case NBR_REACHABLE: ADD(" REACHABLE");break;
      case NBR_STALE: ADD(" STALE");break;      
      case NBR_DELAY: ADD(" DELAY");break;
      case NBR_PROBE: ADD(" NBR_PROBE");break;
      }
}
#else
{uint8_t j=blen+25;
      ipaddr_add(&nbr->ipaddr);
      while (blen < j) ADD(" ");
      switch (nbr->state) {
      case NBR_INCOMPLETE: ADD(" INCOMPLETE");break;
      case NBR_REACHABLE: ADD(" REACHABLE");break;
      case NBR_STALE: ADD(" STALE");break;      
      case NBR_DELAY: ADD(" DELAY");break;
      case NBR_PROBE: ADD(" NBR_PROBE");break;
      }
}
#endif
#else
      ipaddr_add(&nbr->ipaddr);
#endif

      ADD("\n");
#if BUF_USES_STACK
      if(bufptr > bufend - 45) {
        SEND_STRING(&s->sout, buf);
        bufptr = buf; bufend = bufptr + sizeof(buf);
      }
#else
      if(blen > sizeof(buf) - 45) {
        SEND_STRING(&s->sout, buf);
        blen = 0;
      }
#endif
  }
  ADD("</pre>Routes<pre>");
  SEND_STRING(&s->sout, buf);
#if BUF_USES_STACK
  bufptr = buf; bufend = bufptr + sizeof(buf);
#else
  blen = 0;
#endif

  for(r = uip_ds6_route_head(); r != NULL; r = uip_ds6_route_next(r)) {

#if BUF_USES_STACK
#if WEBSERVER_CONF_ROUTE_LINKS
    ADD("<a href=http://[");
    ipaddr_add(&r->ipaddr);
    ADD("]/status.shtml>");
    ipaddr_add(&r->ipaddr);
    ADD("</a>");
#else
    ipaddr_add(&r->ipaddr);
#endif
#else
#if WEBSERVER_CONF_ROUTE_LINKS
    ADD("<a href=http://[");
    ipaddr_add(&r->ipaddr);
    ADD("]/status.shtml>");
    SEND_STRING(&s->sout, buf); //TODO: why tunslip6 needs an output here, wpcapslip does not
    blen = 0;
    ipaddr_add(&r->ipaddr);
    ADD("</a>");
#else
    ipaddr_add(&r->ipaddr);
#endif
#endif
    ADD("/%i (via ", r->length);
    ipaddr_add(uip_ds6_route_nexthop(r));
    if(1 || (r->state.lifetime < 600)) {
      ADD(") %lus\n", r->state.lifetime);
    } else {
      ADD(")\n");
    }
    SEND_STRING(&s->sout, buf);
#if BUF_USES_STACK
    bufptr = buf; bufend = bufptr + sizeof(buf);
#else
    blen = 0;
#endif
  }
  ADD("</pre>");

#if WEBSERVER_CONF_FILESTATS
  static uint16_t numtimes;
  ADD("<br><i>This page sent %i times</i>",++numtimes);
#endif

#if WEBSERVER_CONF_LOADTIME
  numticks = clock_time() - numticks + 1;
  ADD(" <i>(%lu.%02lu sec)</i>", numticks / CLOCK_SECOND, (100*(numticks%CLOCK_SECOND)) / CLOCK_SECOND);
#endif

  ADD("<br><br>\n");
  ADD("</pre>Debug print<pre>");
  ADD(debug_buffer_get_all());

  SEND_STRING(&s->sout, buf);
  SEND_STRING(&s->sout, BOTTOM);

  PSOCK_END(&s->sout);
}
/*---------------------------------------------------------------------------*/
httpd_simple_script_t
httpd_simple_get_script(const char *name)
{

  return generate_routes;
}

#endif /* WEBSERVER */

/*---------------------------------------------------------------------------*/
static void
print_local_addresses(void)
{
  int i;
  uint8_t state;

  PRINTA("Server IPv6 addresses:\n");
  for(i = 0; i < UIP_DS6_ADDR_NB; i++) {
    state = uip_ds6_if.addr_list[i].state;
    if(uip_ds6_if.addr_list[i].isused &&
       (state == ADDR_TENTATIVE || state == ADDR_PREFERRED)) {
      PRINTA(" ");
      uip_debug_ipaddr_print(&uip_ds6_if.addr_list[i].ipaddr);
      PRINTA("\n");
    }
  }
}
/*---------------------------------------------------------------------------*/
void
request_prefix(void)
{
  /* mess up uip_buf with a dirty request... */
  uip_buf[0] = '?';
  uip_buf[1] = 'P';
  uip_len = 2;
  slip_send();
  uip_len = 0;
}
/*---------------------------------------------------------------------------*/
void
set_prefix_64(uip_ipaddr_t *prefix_64)
{
  uip_ipaddr_t ipaddr;
  memcpy(&prefix, prefix_64, 16);
  memcpy(&ipaddr, prefix_64, 16);
  prefix_set = 1;
  uip_ds6_set_addr_iid(&ipaddr, &uip_lladdr);
  uip_ds6_addr_add(&ipaddr, 0, ADDR_AUTOCONF);
}
/*---------------------------------------------------------------------------*/
PROCESS_THREAD(border_router_process, ev, data)
{
  static struct etimer et;
  rpl_dag_t *dag;

  PROCESS_BEGIN();

/* While waiting for the prefix to be sent through the SLIP connection, the future
 * border router can join an existing DAG as a parent or child, or acquire a default 
 * router that will later take precedence over the SLIP fallback interface.
 * Prevent that by turning the radio off until we are initialized as a DAG root.
 */
  prefix_set = 0;
  NETSTACK_MAC.off(0);

  PROCESS_PAUSE();

  PRINTF("RPL-Border router started\n");
#if 0
   /* The border router runs with a 100% duty cycle in order to ensure high
     packet reception rates.
     Note if the MAC RDC is not turned off now, aggressive power management of the
     cpu will interfere with establishing the SLIP connection */
  NETSTACK_MAC.off(1);
#endif
 
  /* Request prefix until it has been received */
  while(!prefix_set) {
    etimer_set(&et, CLOCK_SECOND);
    request_prefix();
    PROCESS_WAIT_EVENT_UNTIL(etimer_expired(&et));
  }

  dag = rpl_set_root(RPL_DEFAULT_INSTANCE,(uip_ip6addr_t *)dag_id);
  if(dag != NULL) {
    rpl_set_prefix(dag, &prefix, 64);
    PRINTF("created a new RPL dag\n");
  }

  /* Now turn the radio on, but disable radio duty cycling.
   * Since we are the DAG root, reception delays would constrain mesh throughbut.
   */
  NETSTACK_MAC.off(1);
  
#if DEBUG || 1
  print_local_addresses();
#endif

  TIM_TimeBaseInitTypeDef  TIM_TimeBaseStructure;
  uint16_t PrescalerValue = 0;

  RCC_APB1PeriphClockCmd(RCC_APB1Periph_TIM5, ENABLE);

  PrescalerValue = (uint16_t) ((168000000 / 2) / 1000000) - 1;

  /* Time base configuration */
  TIM_TimeBaseStructure.TIM_Period = 0xFFFFFFFF;
  TIM_TimeBaseStructure.TIM_Prescaler = 0;
  TIM_TimeBaseStructure.TIM_ClockDivision = 0;
  TIM_TimeBaseStructure.TIM_CounterMode = TIM_CounterMode_Up;
  TIM_TimeBaseInit(TIM5, &TIM_TimeBaseStructure);

  // Prescaler configuration
  TIM_PrescalerConfig(TIM5, PrescalerValue, TIM_PSCReloadMode_Immediate);

  // Disable ARR buffering
  TIM_ARRPreloadConfig(TIM5, DISABLE);
  
  // Enable the timer
  TIM_Cmd(TIM5, ENABLE);
  
  TIM5->CNT = 0;
  
  // Multicast
  static uip_ipaddr_t client_addr;
  uip_ip6addr(&client_addr, 0xff02, 0, 0, 0, 0, 0, 0, 0x1);
  client_conn = udp_new(&client_addr, UIP_HTONS(3009), NULL);
  udp_bind(client_conn, UIP_HTONS(3010));
  
  static struct etimer timer;
  etimer_set(&timer, 2 * CLOCK_CONF_SECOND);
  
  for (;;) {
    PROCESS_WAIT_EVENT_UNTIL(ev == PROCESS_EVENT_TIMER);
    
    rpl_repair_root(RPL_DEFAULT_INSTANCE);
    unsigned long tim_cnt_tmp = TIM5->CNT;
    unsigned long tim_cnt = UIP_HTONL(tim_cnt_tmp);
    uip_ipaddr_copy(&client_conn->ripaddr, &client_addr);
    uip_udp_packet_send(client_conn, (unsigned char*)&tim_cnt, 4);
    
    leds_toggle(LEDS_GREEN);
    
    etimer_reset(&timer);
  }

  PROCESS_END();
}
/*---------------------------------------------------------------------------*/
