vedderb/QuadcopterSystem/Embedded/QuadcopterMain/adconv.c

/*
	Copyright 2013-2015 Benjamin Vedder	benjamin@vedder.se

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
    You should have received a copy of the GNU General Public License
    along with this program.  If not, see <http://www.gnu.org/licenses/>.
 */

#include "adconv.h"

// Settings
#define V_REG					3.3
#define VIN_R1					10000.0
#define VIN_R2					2200.0
#define VREFINT					1.21

#define ADC_GRP_NUM_CHANNELS	8
#define ADC_GRP_BUF_DEPTH		1

static adcsample_t samples[ADC_GRP_NUM_CHANNELS * ADC_GRP_BUF_DEPTH];

//static void adccallback(ADCDriver *adcp, adcsample_t *buffer, size_t n) {
//	(void)adcp;
//	(void)buffer;
//	(void)n;
//}
//
//static void adcerrorcallback(ADCDriver *adcp, adcerror_t err) {
//	(void)adcp;
//	(void)err;
//}

/*
 * ADC conversion group.
 * Mode:        Continuous, 16 samples of 8 channels, SW triggered.
 * Channels:    IN11, IN12, IN11, IN12, IN11, IN12, Sensor, VRef.
 */
static const ADCConversionGroup adcgrpcfg = {
		TRUE,
		ADC_GRP_NUM_CHANNELS,
		0,//adccallback,
		0,//adcerrorcallback,
		0,                        /* CR1 */
		ADC_CR2_SWSTART,          /* CR2 */
		ADC_SMPR1_SMP_AN10(ADC_SAMPLE_56) |
		ADC_SMPR1_SMP_AN11(ADC_SAMPLE_56) |
		ADC_SMPR1_SMP_AN12(ADC_SAMPLE_56) |
		ADC_SMPR1_SMP_AN13(ADC_SAMPLE_56) |
		ADC_SMPR1_SMP_SENSOR(ADC_SAMPLE_144) |
		ADC_SMPR1_SMP_VREF(ADC_SAMPLE_144),
		ADC_SMPR2_SMP_AN4(ADC_SAMPLE_56), /* SMPR2 */
		ADC_SQR1_NUM_CH(ADC_GRP_NUM_CHANNELS),
		ADC_SQR2_SQ8_N(ADC_CHANNEL_SENSOR) | ADC_SQR2_SQ7_N(ADC_CHANNEL_VREFINT),
		ADC_SQR3_SQ6_N(ADC_CHANNEL_IN4)  | ADC_SQR3_SQ5_N(ADC_CHANNEL_IN13) |
		ADC_SQR3_SQ4_N(ADC_CHANNEL_IN12) | ADC_SQR3_SQ3_N(ADC_CHANNEL_IN11) |
		ADC_SQR3_SQ2_N(ADC_CHANNEL_IN10) | ADC_SQR3_SQ1_N(ADC_CHANNEL_IN4)
};

void adconv_init(void) {
	palSetPadMode(GPIOA, 4, PAL_MODE_INPUT_ANALOG);
	palSetPadMode(GPIOC, 0, PAL_MODE_INPUT_ANALOG);
	palSetPadMode(GPIOC, 1, PAL_MODE_INPUT_ANALOG);
	palSetPadMode(GPIOC, 2, PAL_MODE_INPUT_ANALOG);
	palSetPadMode(GPIOC, 3, PAL_MODE_INPUT_ANALOG);

	adcStart(&ADCD1, NULL);
	adcSTM32EnableTSVREFE();

	adcStartConversion(&ADCD1, &adcgrpcfg, samples, ADC_GRP_BUF_DEPTH);
}

/**
 * Get the input voltage from the battery.
 */
float adconv_get_vin(void) {
	return ((V_REG / 4095.0) * (float)samples[0] * ((VIN_R1 + VIN_R2) / VIN_R2));
}

/**
 * Get the raw ADC value from one of the pins on the ADC_GPIO header.
 */
uint16_t adconv_get_adc_pin(int pin) {
	if (pin < 0 || pin >= 4) {
		return 0;
	}

	return samples[pin + 1];
}
