vedderb/QuadcopterSystem/Linux/QuadcopterTool/serialport.h

/*
    Copyright 2012 Benjamin Vedder	benjamin@vedder.se

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
    You should have received a copy of the GNU General Public License
    along with this program.  If not, see <http://www.gnu.org/licenses/>.
    */

#ifndef SERIALPORT_H
#define SERIALPORT_H

#include <QMutex>
#include <QSize>
#include <QThread>
#include <QWaitCondition>

class SerialPort : public QThread
{
    Q_OBJECT

public:
    SerialPort(QObject *parent = 0);
    ~SerialPort();

    enum SerialParity {PARITY_NONE, PARITY_EVEN, PARITY_ODD};
    enum SerialDataBits {DATA_5, DATA_6, DATA_7, DATA_8};
    enum SerialStopBits {STOP_1, STOP_2};

    struct SerialSettings {
        SerialParity parity;
        int baudrate;
        SerialDataBits dataBits;
        SerialStopBits stopBits;
    };

    int openPort(
        const QString& port,
        int baudrate = 115200,
        SerialDataBits dataBits = DATA_8,
        SerialStopBits stopBits = STOP_1,
        SerialParity parity = PARITY_NONE);

    void closePort();
    bool setBaudrate(int baudrate);
    bool setParity(SerialParity parity);
    bool setStopBits(SerialStopBits stopBits);
    bool setDataBits(SerialDataBits dataBits);
    bool readByte(char& byte);
    int readBytes(char* buffer, int bytes);
    int readString(QString& string, int length);
    QByteArray readAll();
    int writeData(const char* data, int length, bool block = true);
    bool writeByte(char byte, bool block = true);
    bool writeString(const QString& string, bool block = true);
    int bytesAvailable();
    bool isOpen();
    int captureBytes(char* buffer, int num, int timeoutMs = 0, const QString& preTransmit = "");
    int captureBytes(char* buffer, int num, int timeoutMs = 0, const char* preTransmit = 0, int preTransLen = 0);

Q_SIGNALS:
    void serial_data_available();
    void serial_port_error(int e);

public Q_SLOTS:

protected:
    void run();

private:
    QMutex mMutex;
    QWaitCondition mCondition;
    bool mAbort;
    bool mIsOpen;

    SerialSettings mSettings;
    int mFd;

    int mBufferSize;
    char* mReadBuffer;
    int mBufferRead;
    int mBufferWrite;

    int mCaptureBytes;
    char* mCaptureBuffer;
    int mCaptureWrite;
};

#endif // SERIALPORT_H
