vedderb/QuadcopterSystem/(notices)

Notices in the files:
Embedded/QuadcopterMain/safety.c:
This program is free software: you can redistribute it and/or modify
it under the terms of the GNU General Public License as published by
the Free Software Foundation, either version 3 of the License, or
(at your option) any later version.
Linux/CopterSimGui/mainwindow.cpp:
CopterSimGui is free software: you can redistribute it and/or modify
it under the terms of the GNU Lesser General Public License as published by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
